flipoyo/MOLONARI-hardware/Boite/deploiement/tige/Lien_onshape.md

Cliquez sur ce lien pour avoir accès au Onshape si vous souhaitez modifier: 
https://cad.onshape.com/documents/2f37f9a7a72e3b844bc26cf5/w/325063e0cb311e8a45c4c956/e/2f46907a06a0c7d93dc3eaa5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
Sinon vous avez directement le document STL.
