flipoyo/MOLONARI-hardware/specs/v2-2025/sensors/temperature sensor/RECORDS_corrige.xlsx

Sheet: Measurements
Device_ID | Record | Date | Time | Value_1 | Value_2 | Value_3 | Value_4 | Value_5 | Last_number | True_temperature_C | Last number normalized
a8610a34334d710d | 7 | 30/10/2026 | 14:40:03 | 1773 | 2502 | 2036 | 2002 | 2031 | 2013 | 20 | 1.622197802
a8610a34334d710d | 8 | 30/10/2026 | 14:40:08 | 1763 | 2503 | 2035 | 2000 | 2026 | 2010 | 20 | 1.61978022
a8610a34334d710d | 9 | 30/10/2026 | 14:40:13 | 1802 | 2502 | 2038 | 2003 | 2030 | 2014 | 20 | 1.623003663
a8610a34334d710d | 10 | 30/10/2026 | 14:40:18 | 1765 | 2504 | 2038 | 2002 | 2029 | 2011 | 20 | 1.620586081
a8610a34334d710d | 11 | 30/10/2026 | 14:40:23 | 1791 | 2504 | 2040 | 2005 | 2031 | 2011 | 20 | 1.620586081
a8610a34334d710d | 12 | 30/10/2026 | 14:40:28 | 1810 | 2507 | 2038 | 2004 | 2027 | 2010 | 20 | 1.61978022
a8610a34334d710d | 13 | 30/10/2026 | 14:40:33 | 1793 | 2508 | 2039 | 2004 | 2030 | 2015 | 20 | 1.623809524
a8610a34334d710d | 14 | 30/10/2026 | 14:40:38 | 1787 | 2508 | 2038 | 2003 | 2028 | 2012 | 20 | 1.621391941
a8610a34334d710d | 15 | 30/10/2026 | 14:40:43 | 1795 | 2507 | 2041 | 2002 | 2028 | 2014 | 20 | 1.623003663
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
