flipoyo/MOLONARI-hardware/docs/Images/atmocommand_sine.png

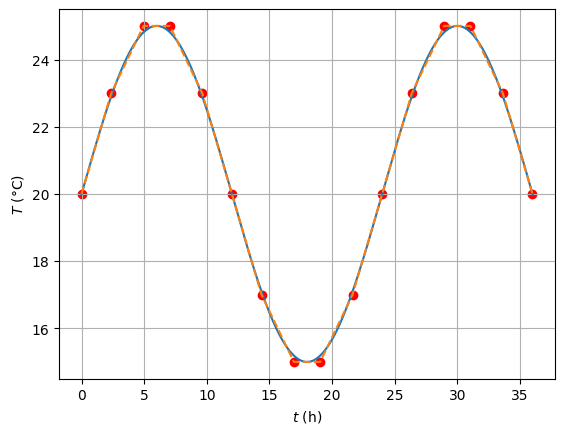
docs/Images/atmocommand_sine.png
