flipoyo/MOLONARI-hardware/docs/Images/basic_station.png

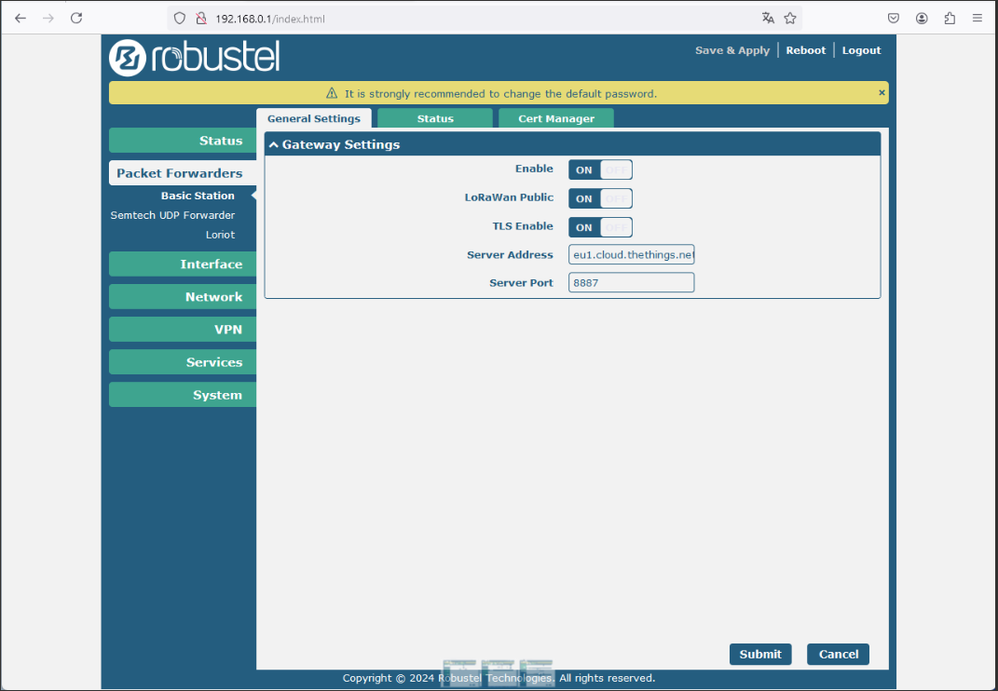
docs/Images/basic_station.png
