flipoyo/MOLONARI-hardware/docs/Images/begin.jpg

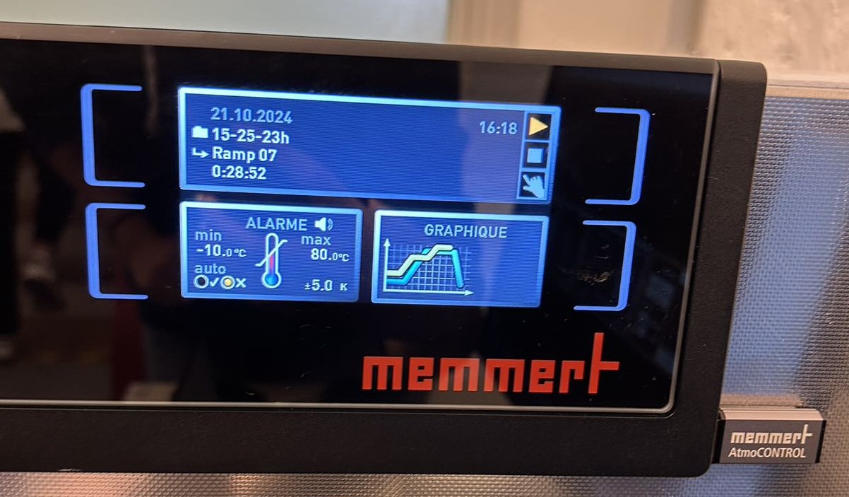
docs/Images/begin.jpg
