flipoyo/MOLONARI-hardware/docs/Images/button.png

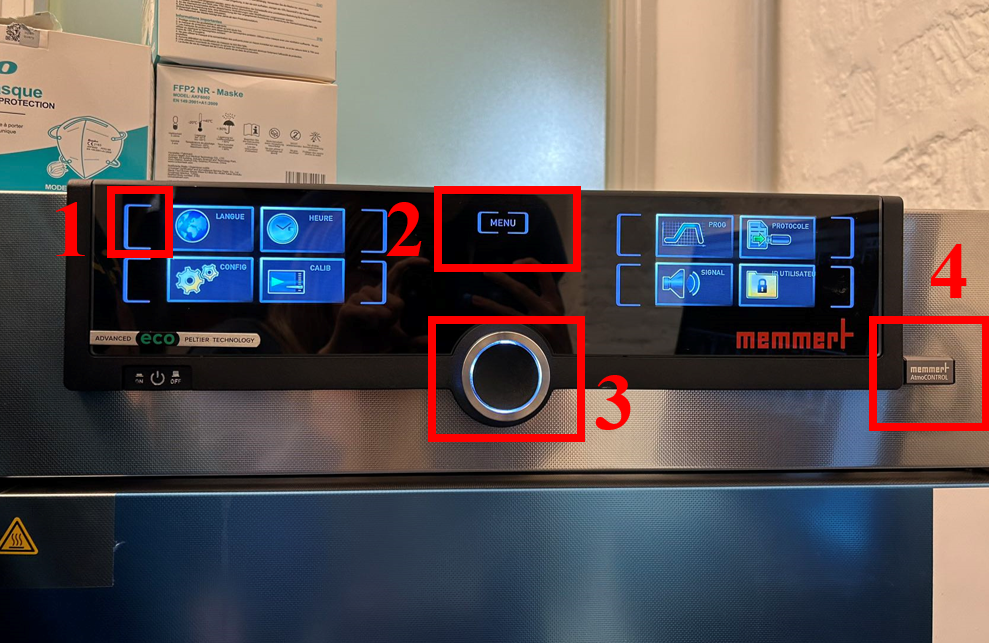
docs/Images/button.png
