flipoyo/MOLONARI-hardware/docs/Images/Cert_manager.png

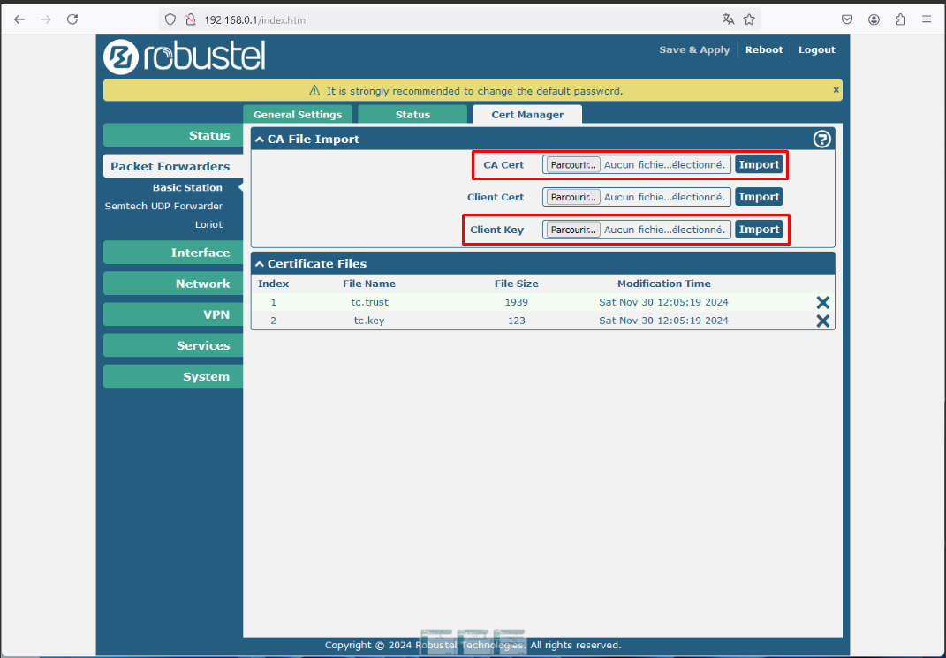
docs/Images/Cert_manager.png
