flipoyo/MOLONARI-hardware/docs/Images/Chaine_informations.jpg

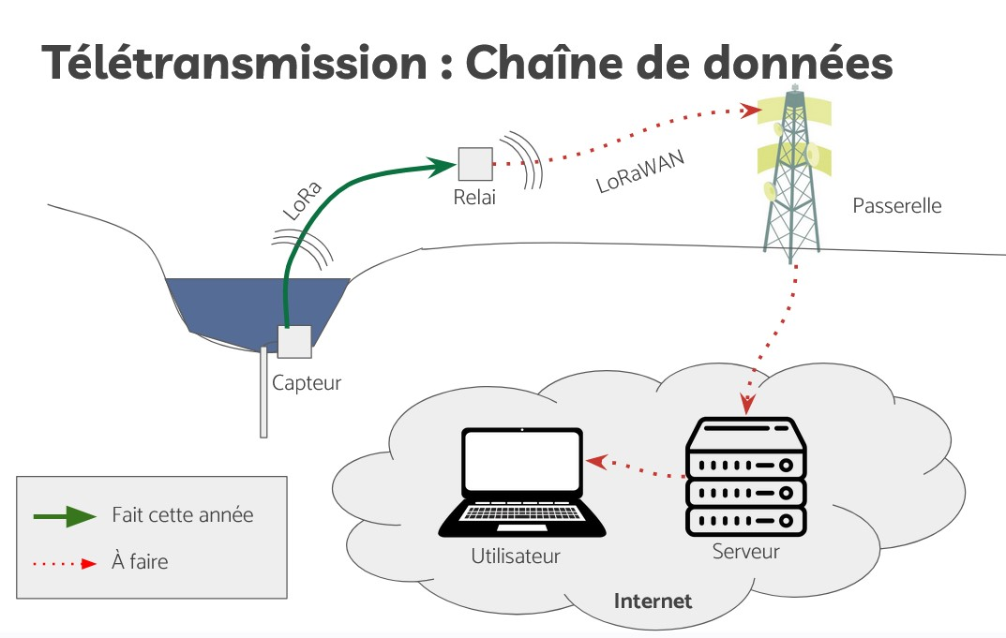
docs/Images/Chaine_informations.jpg
