flipoyo/MOLONARI-hardware/docs/Images/create_programs.png

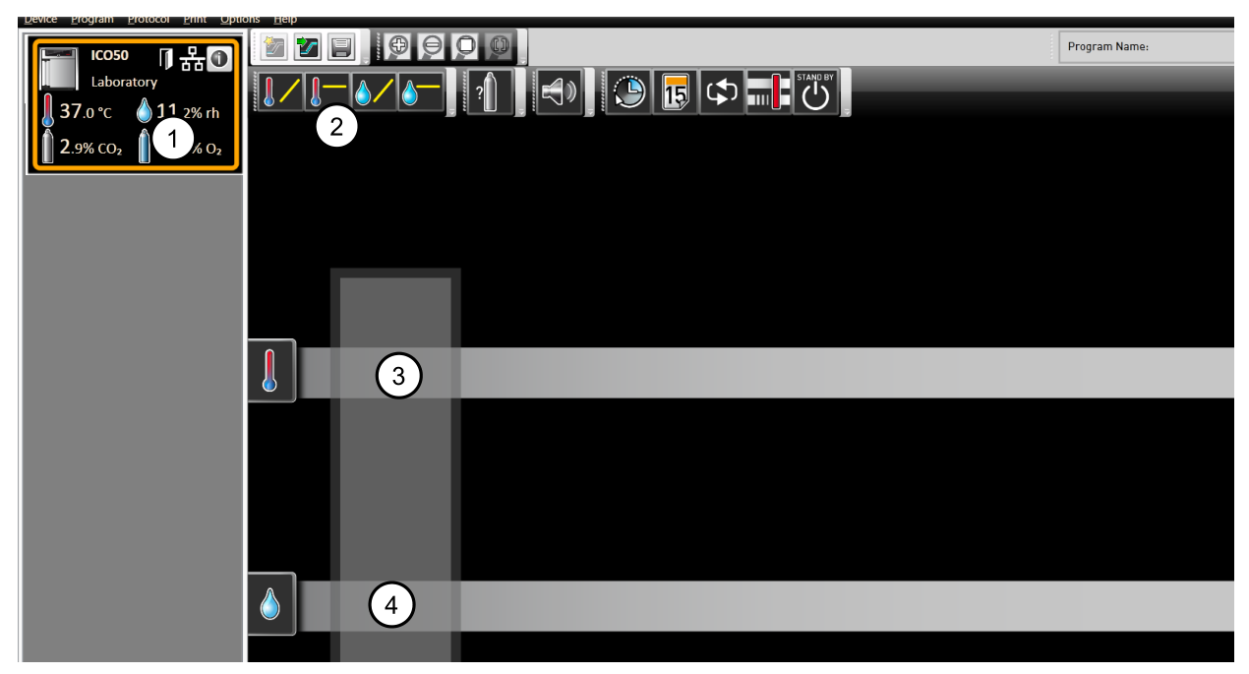
docs/Images/create_programs.png
