flipoyo/MOLONARI-hardware/docs/Images/download.png

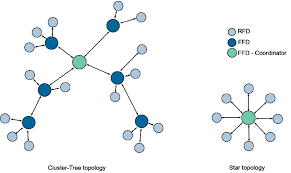
docs/Images/download.png
