flipoyo/MOLONARI-hardware/docs/Images/drag.png

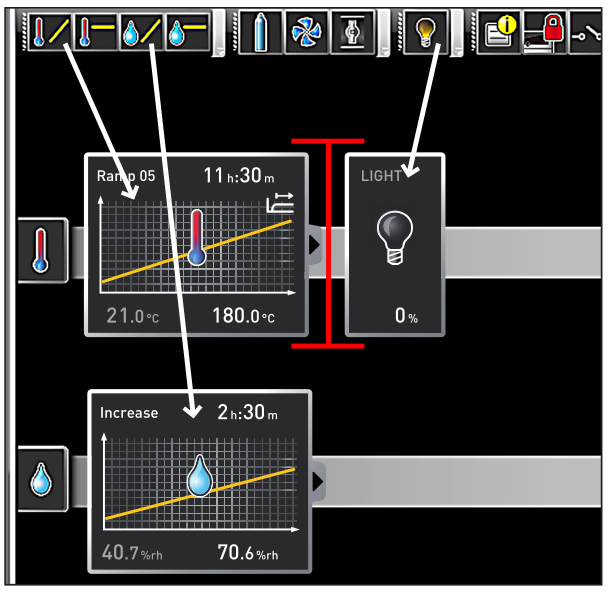
docs/Images/drag.png
