flipoyo/MOLONARI-hardware/docs/Images/first.png

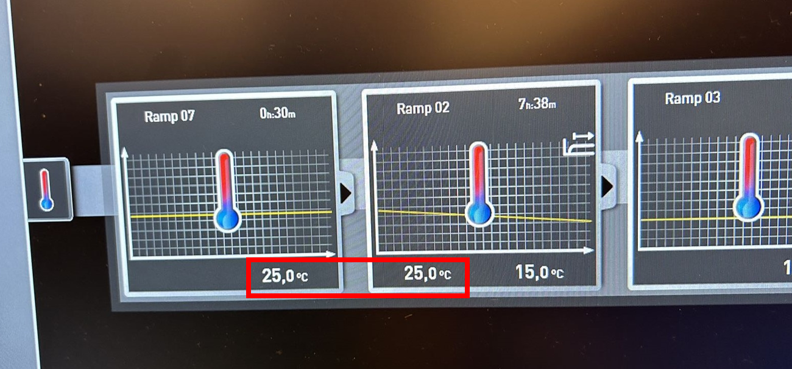
docs/Images/first.png
