flipoyo/MOLONARI-hardware/docs/Images/interface.png

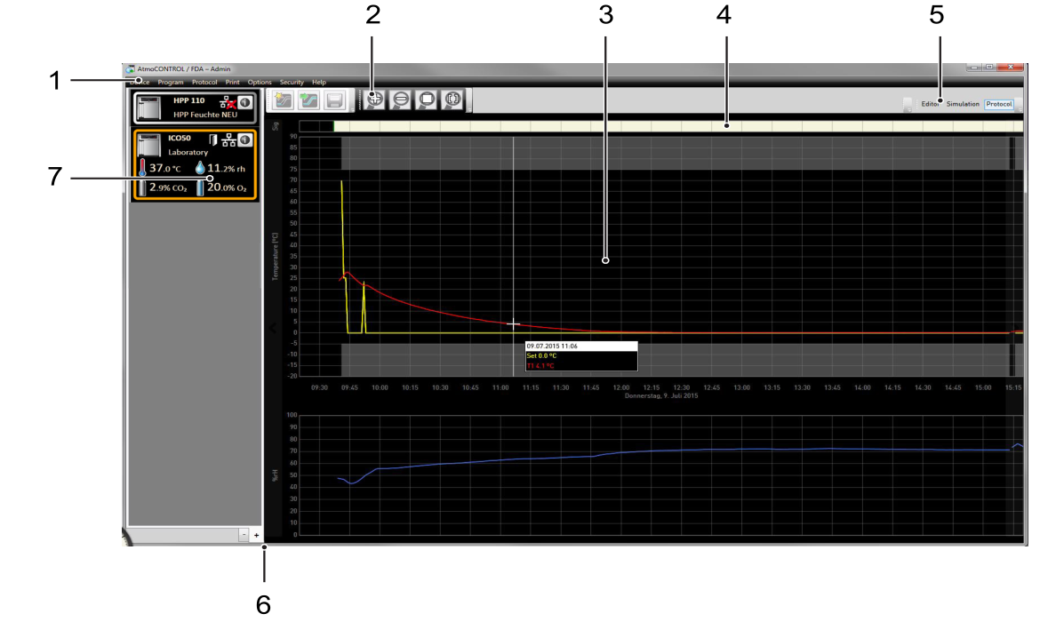
docs/Images/interface.png
