flipoyo/MOLONARI-hardware/docs/Images/json_data.png

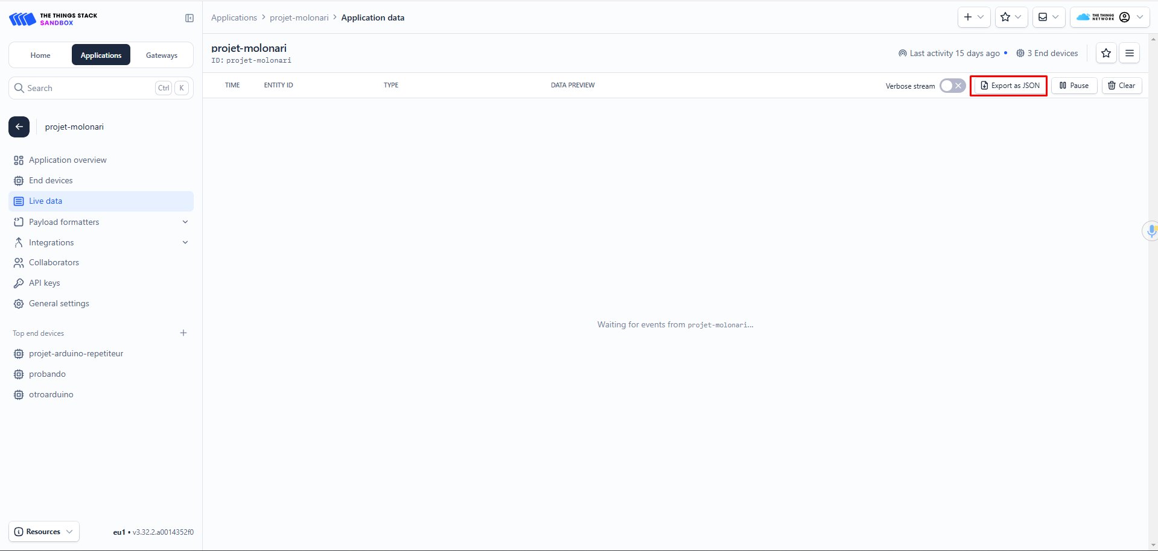
docs/Images/json_data.png
