flipoyo/MOLONARI-hardware/docs/Images/menu_bar.png

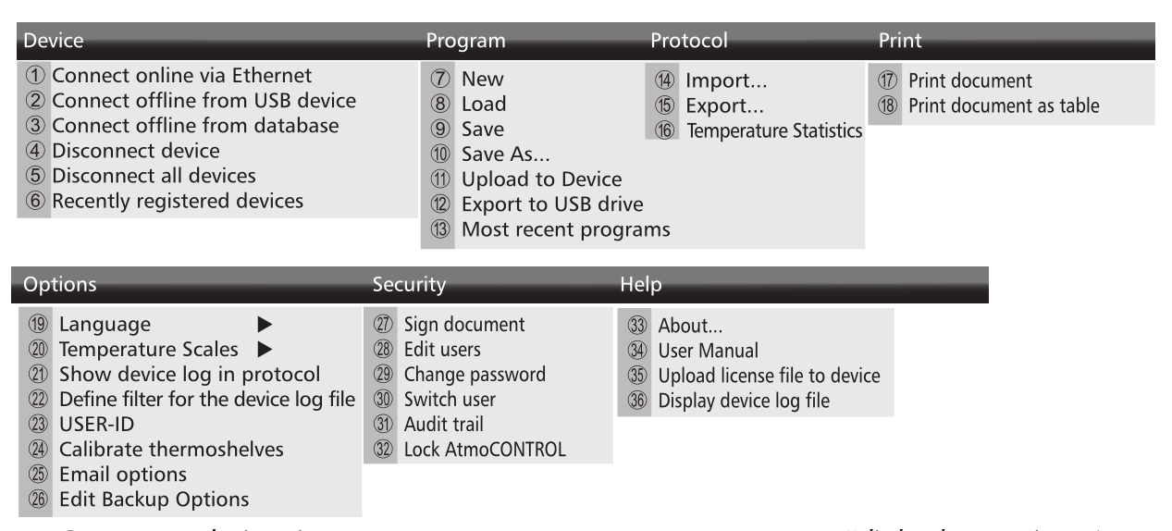
docs/Images/menu_bar.png
