flipoyo/MOLONARI-hardware/docs/Images/off_semtech.png

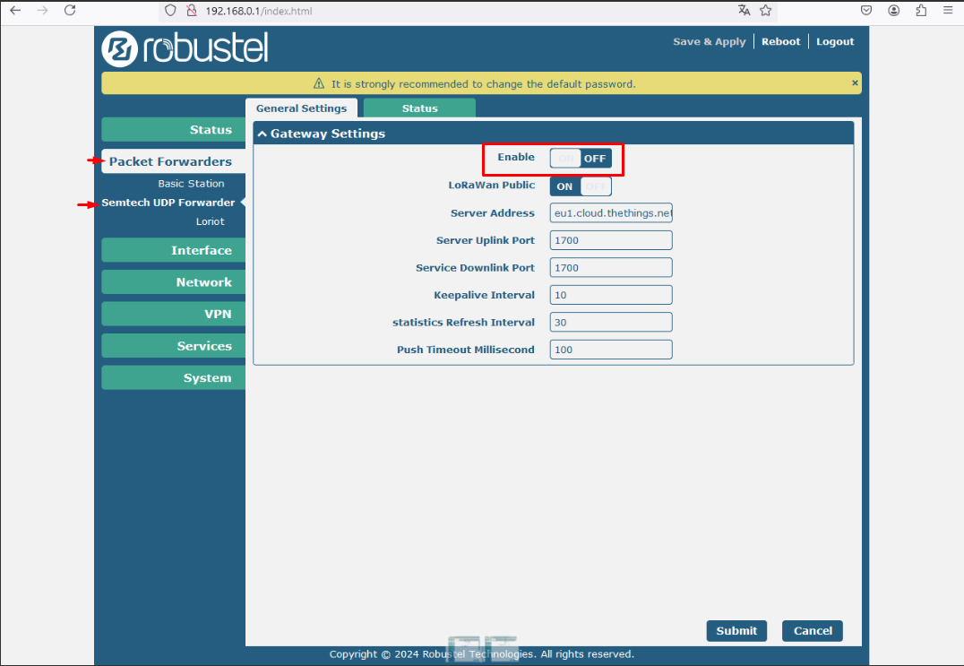
docs/Images/off_semtech.png
