flipoyo/MOLONARI-hardware/docs/Images/para.png

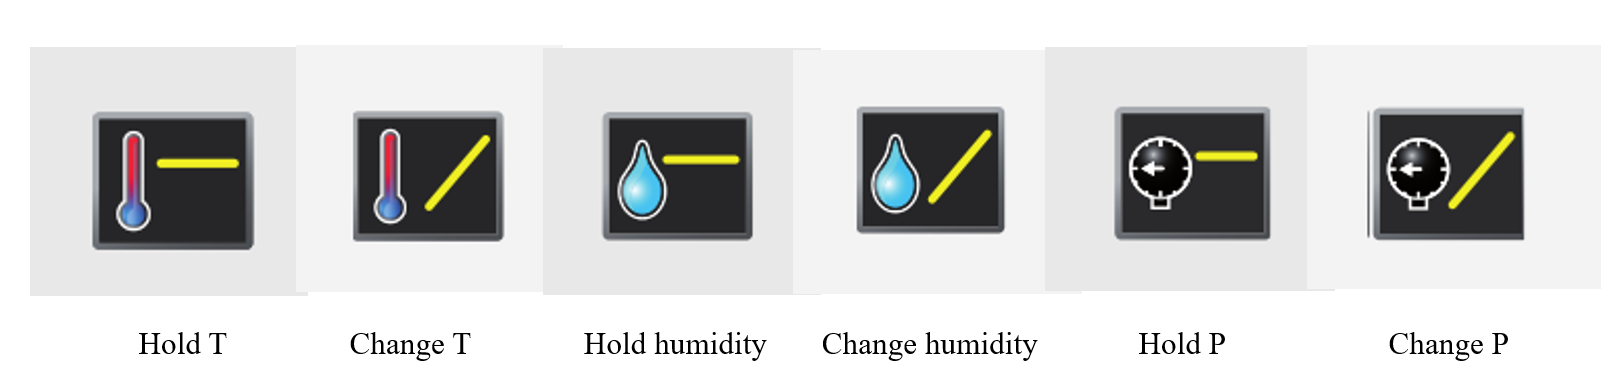
docs/Images/para.png
