flipoyo/MOLONARI-hardware/docs/Images/parameters.png

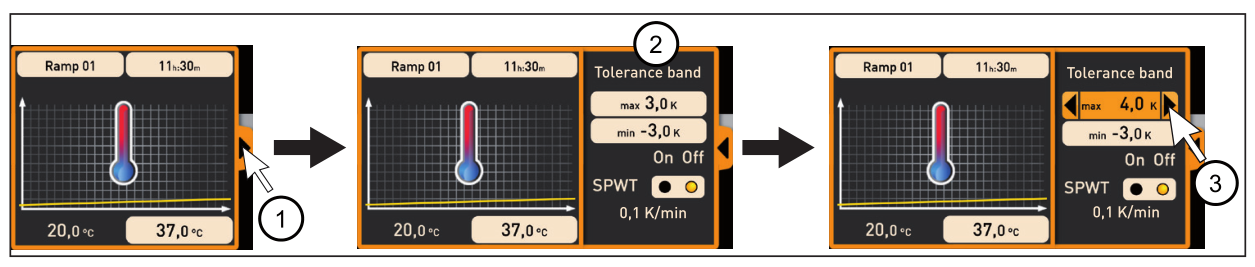
docs/Images/parameters.png
