flipoyo/MOLONARI-hardware/docs/Images/root_pem.png

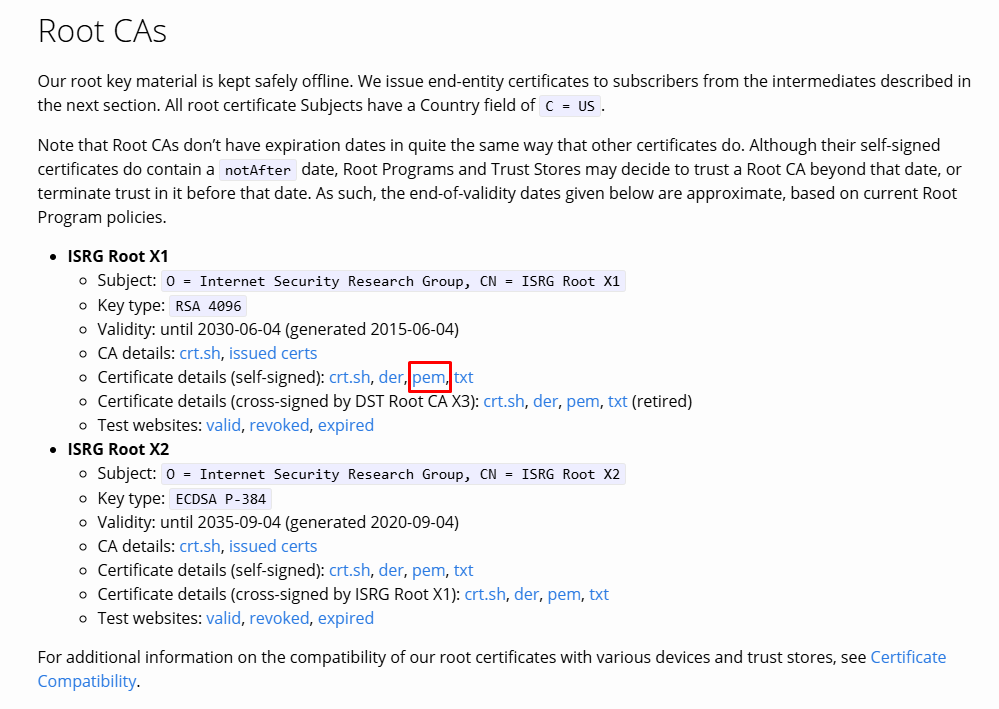
docs/Images/root_pem.png
