flipoyo/MOLONARI-hardware/docs/Images/run.jpg

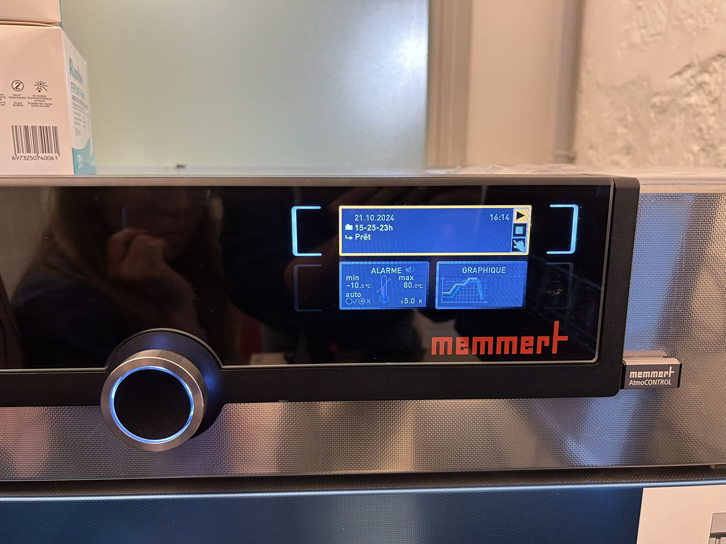
docs/Images/run.jpg
