flipoyo/MOLONARI-hardware/docs/Images/save.jpg

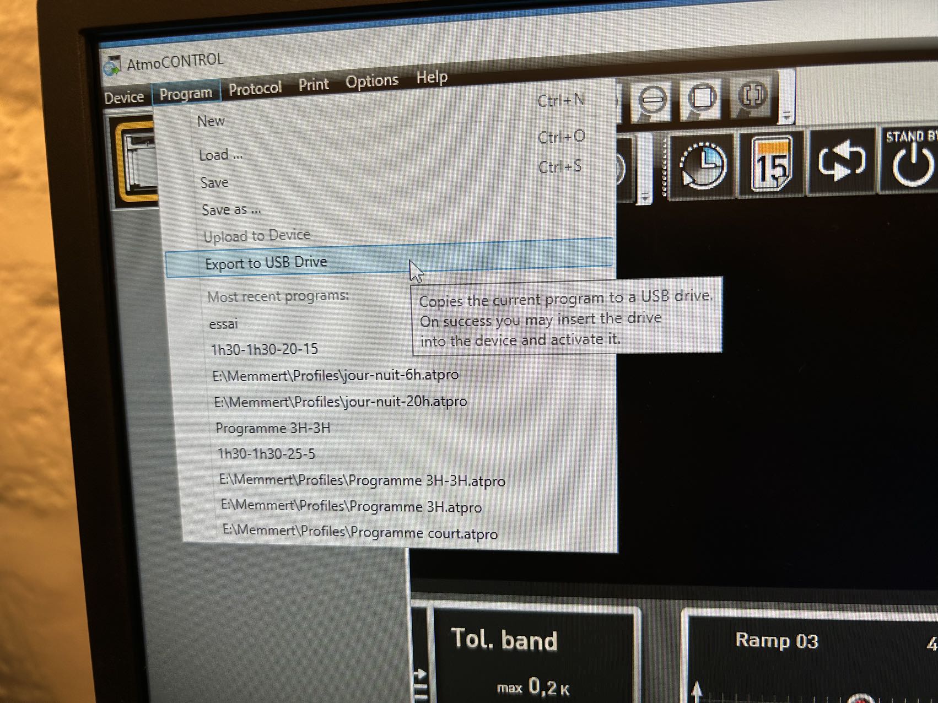
docs/Images/save.jpg
