flipoyo/MOLONARI-hardware/docs/Images/schéma_branchement.png

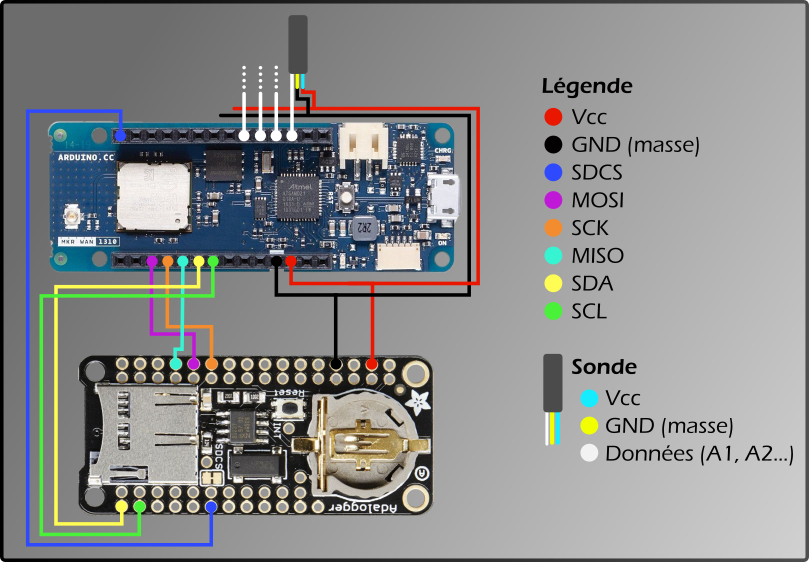
docs/Images/schéma_branchement.png
