flipoyo/MOLONARI-hardware/docs/Images/Screenshot2024-11-30.png

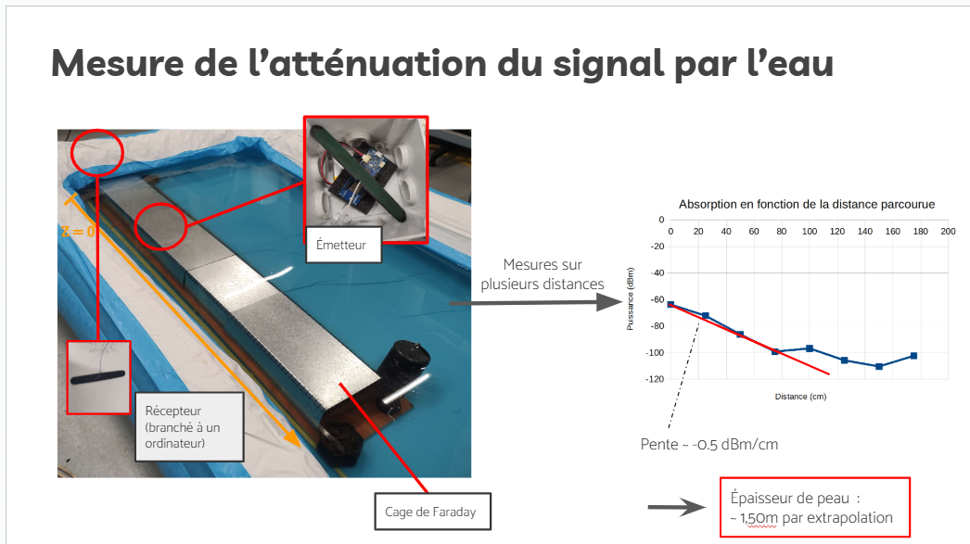
docs/Images/Screenshot2024-11-30.png
