flipoyo/MOLONARI-hardware/docs/Images/select.jpg

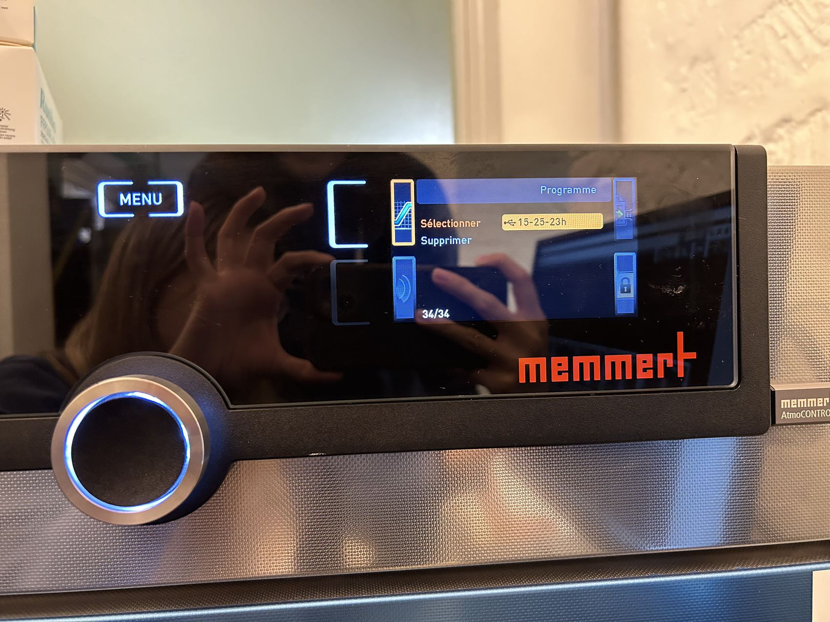
docs/Images/select.jpg
