flipoyo/MOLONARI-hardware/docs/Images/sinus_to_trapezoid.jpg

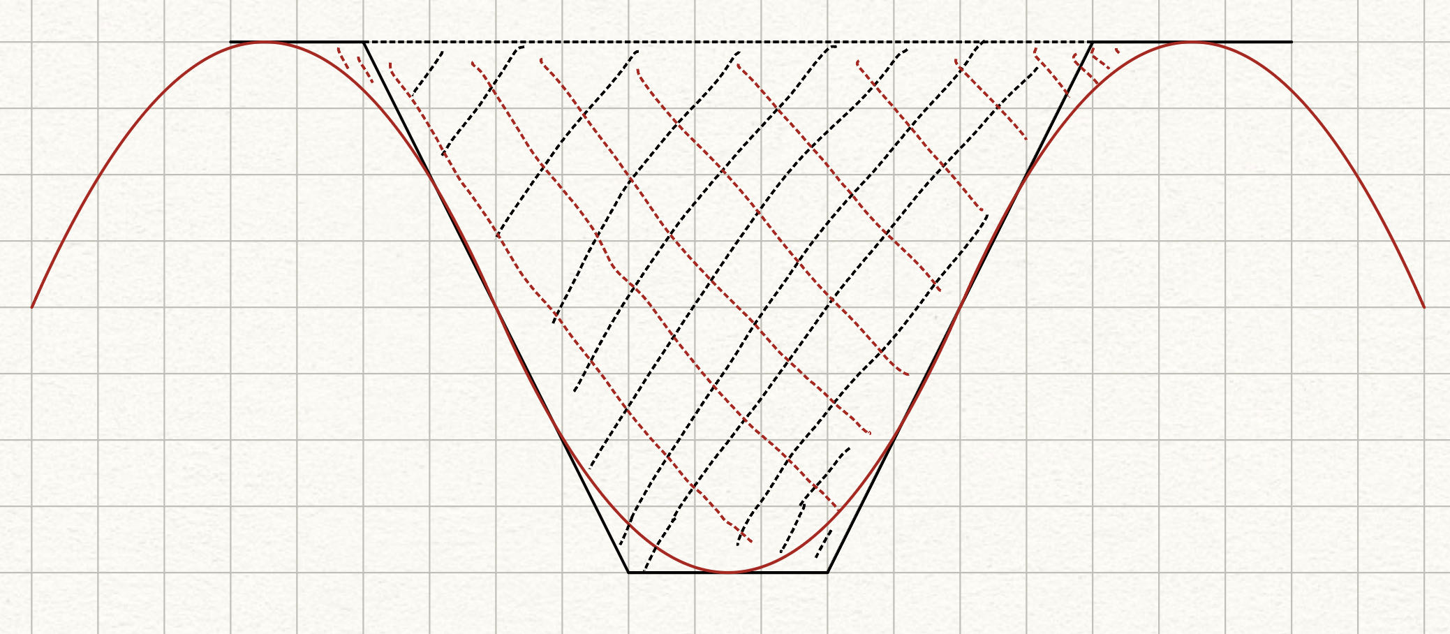
docs/Images/sinus_to_trapezoid.jpg
