flipoyo/MOLONARI-hardware/docs/Images/SPWT.png

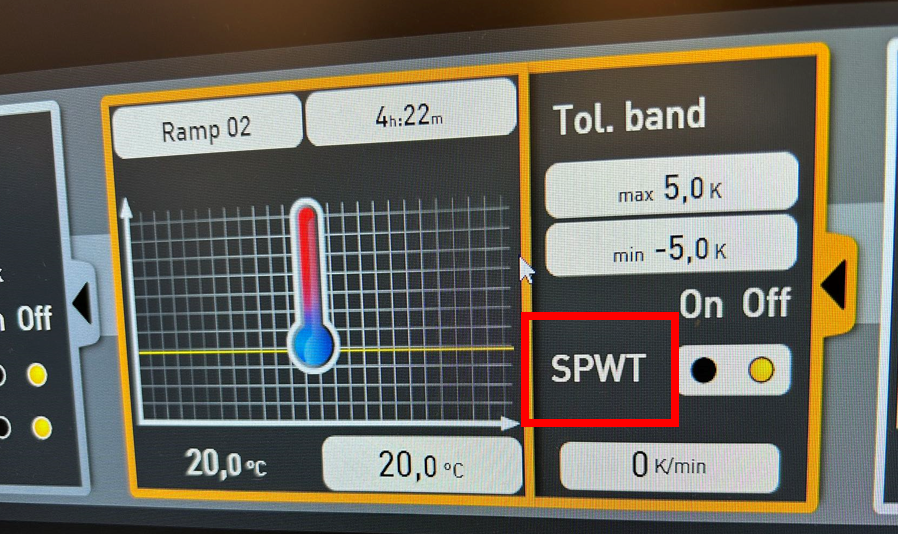
docs/Images/SPWT.png
