flipoyo/MOLONARI-hardware/docs/Images/status_bar.png

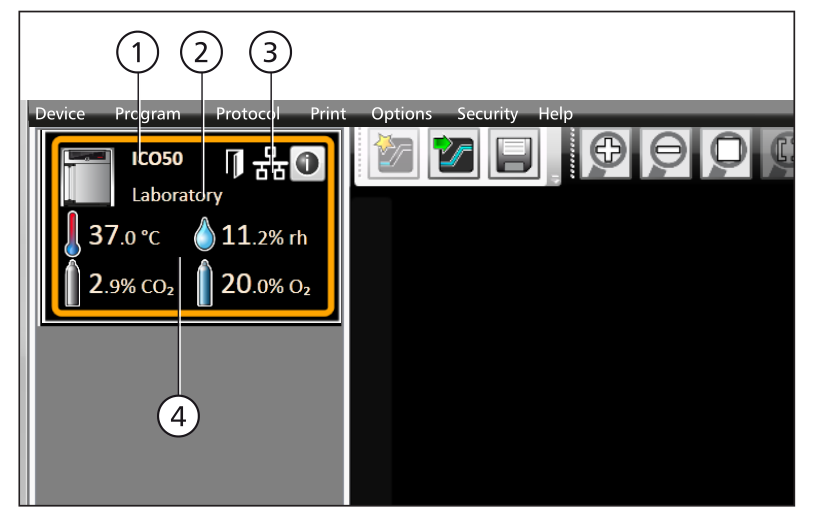
docs/Images/status_bar.png
