flipoyo/MOLONARI-hardware/docs/Images/tol.png

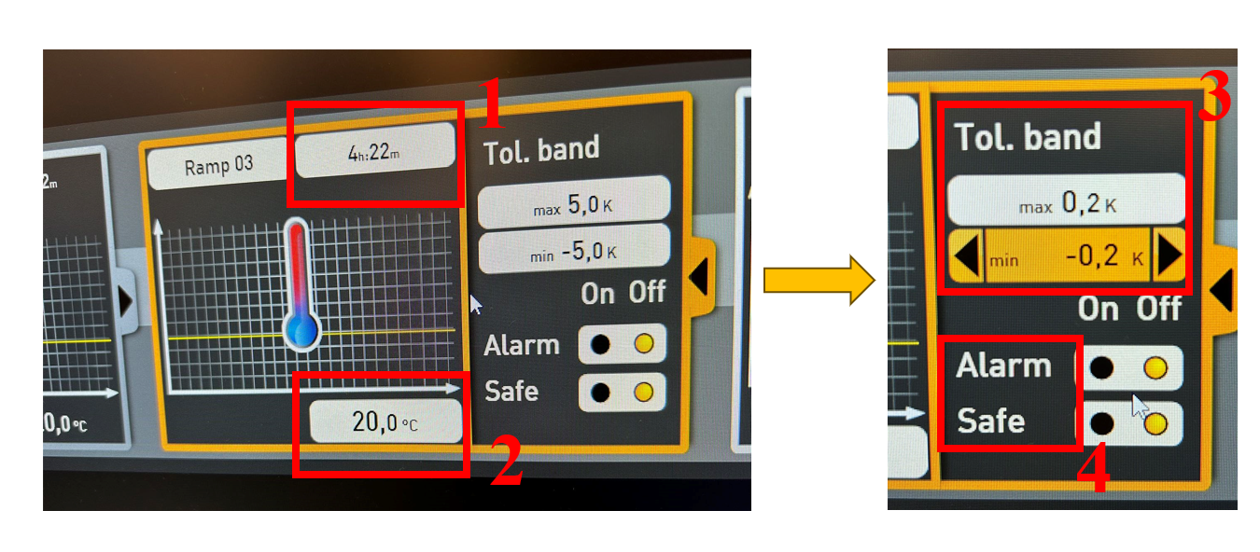
docs/Images/tol.png
