flipoyo/MOLONARI-hardware/docs/Images/toolbar.png

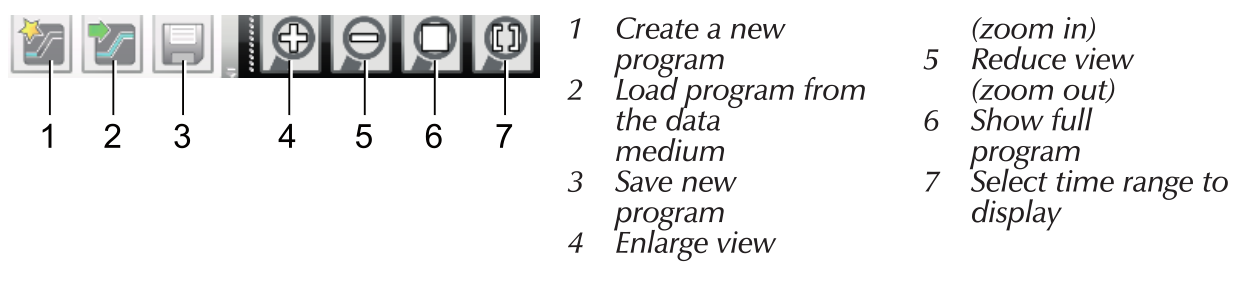
docs/Images/toolbar.png
