flipoyo/MOLONARI-hardware/docs/Images/tree_topology.png

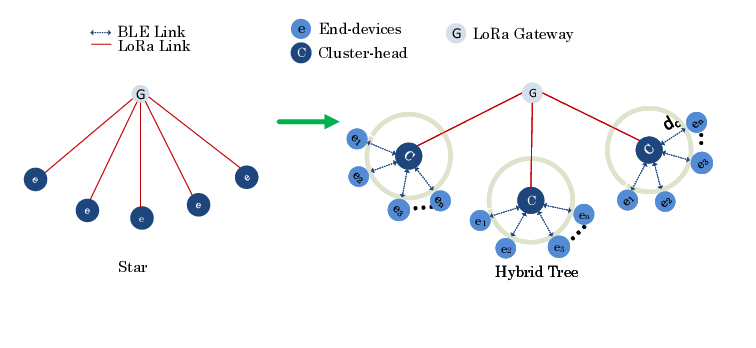
docs/Images/tree_topology.png
