flipoyo/MOLONARI-hardware/docs/Images/v003.jpg

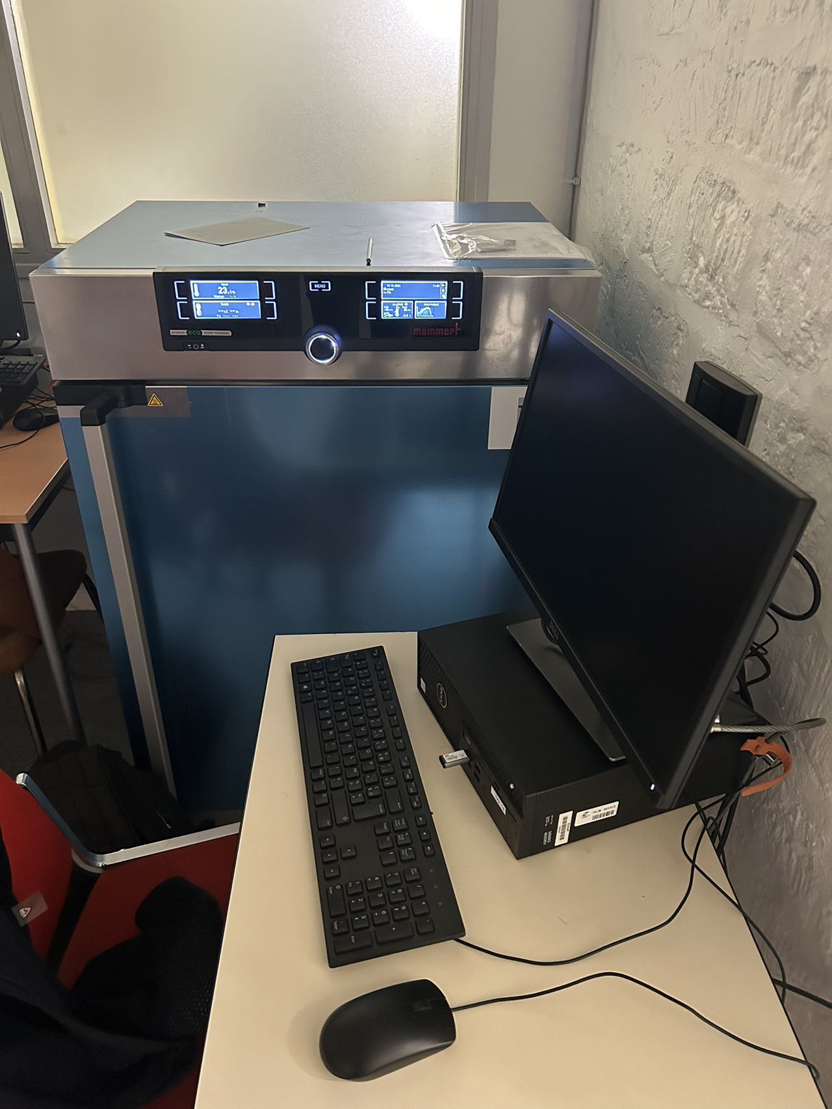
docs/Images/v003.jpg
