flipoyo/MOLONARI-hardware/specs/v1-until-2024/differentialPressureSensor/dimensionSacrificialTip.JPG

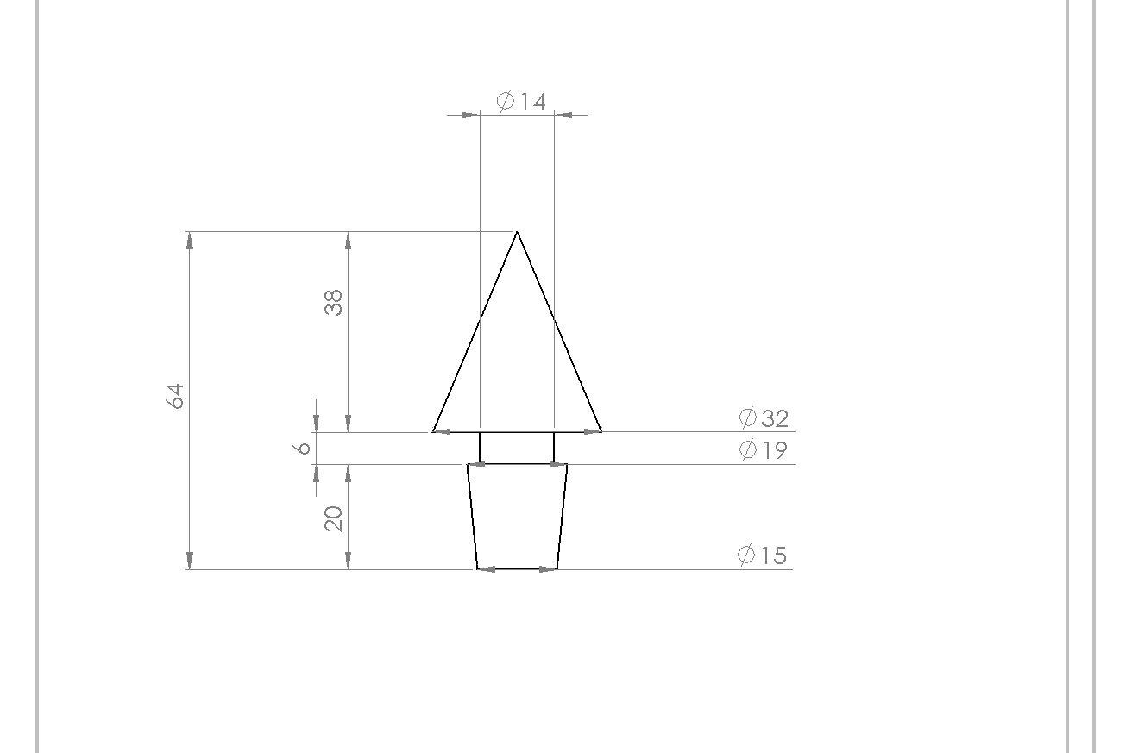
specs/v1-until-2024/differentialPressureSensor/dimensionSacrificialTip.JPG
