flipoyo/MOLONARI-hardware/specs/v1-until-2024/differentialPressureSensor/Schéma_Circuit_crédit_Greswell.jpg

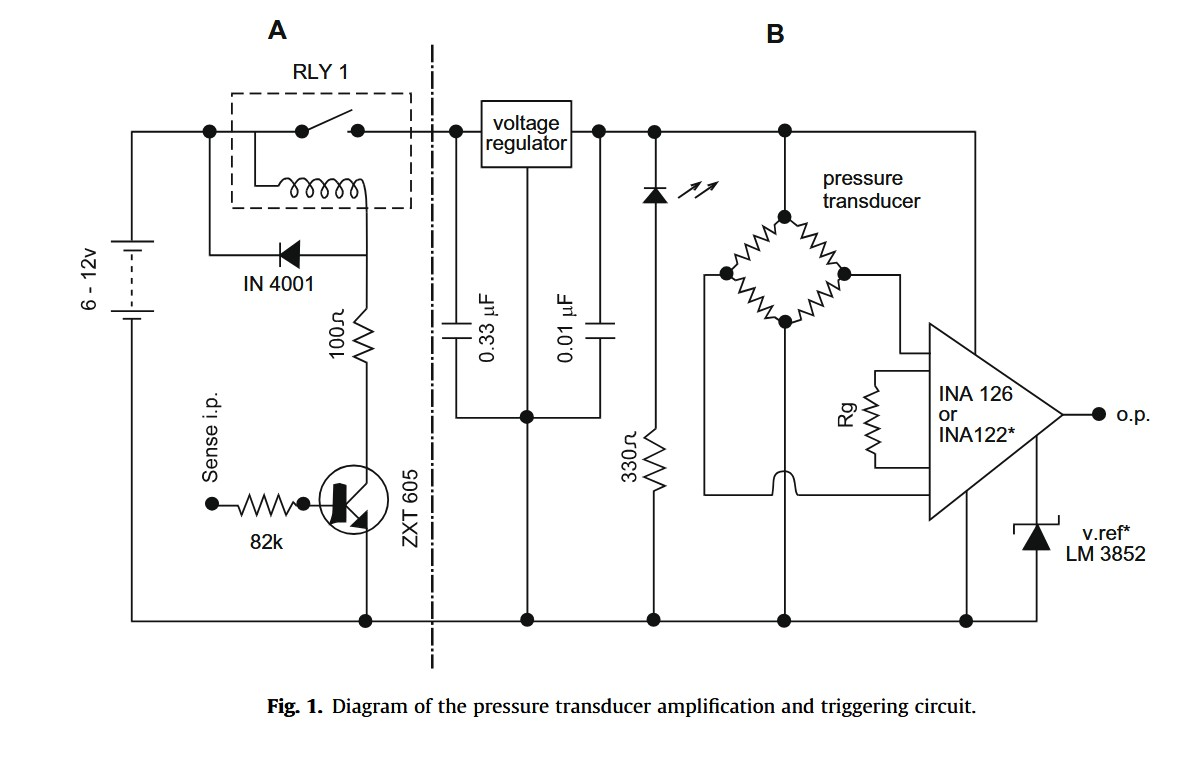
specs/v1-until-2024/differentialPressureSensor/Schéma_Circuit_crédit_Greswell.jpg
