flipoyo/MOLONARI-hardware/specs/v2-2025/electronic connexion/Images/battery_Arduino.jpg

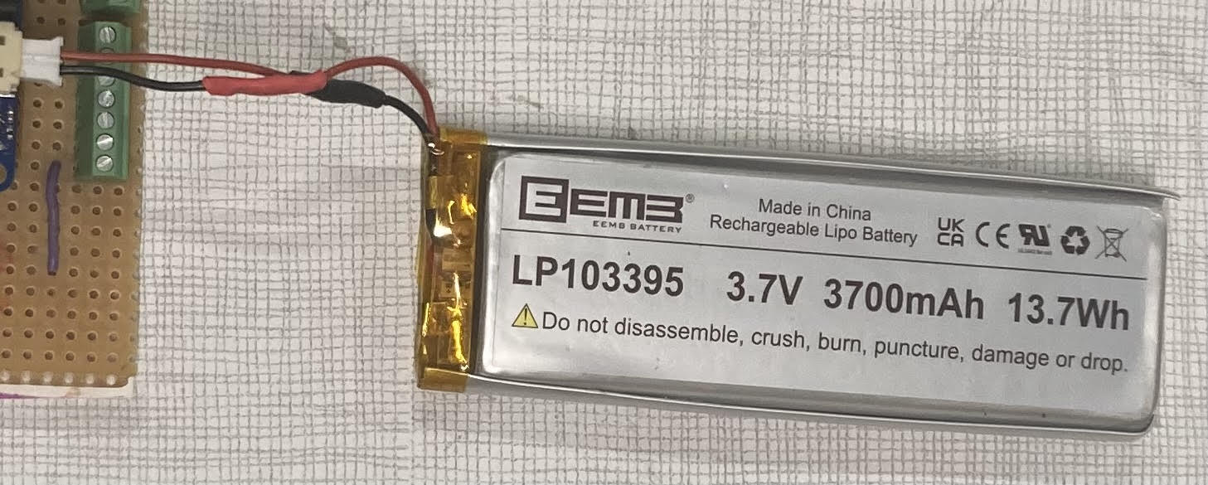
specs/v2-2025/electronic connexion/Images/battery_Arduino.jpg
