flipoyo/MOLONARI-hardware/specs/v2-2025/electronic connexion/Images/circuit_relai_antenne.jpg

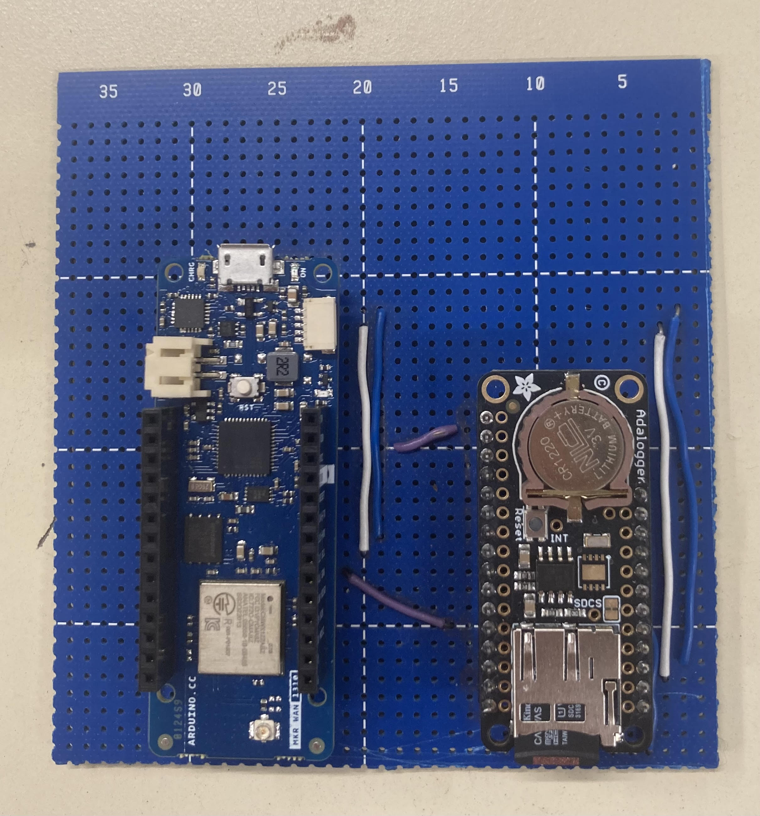
specs/v2-2025/electronic connexion/Images/circuit_relai_antenne.jpg
