flipoyo/MOLONARI-hardware/specs/v2-2025/electronic connexion/Images/circuit_seal.jpg

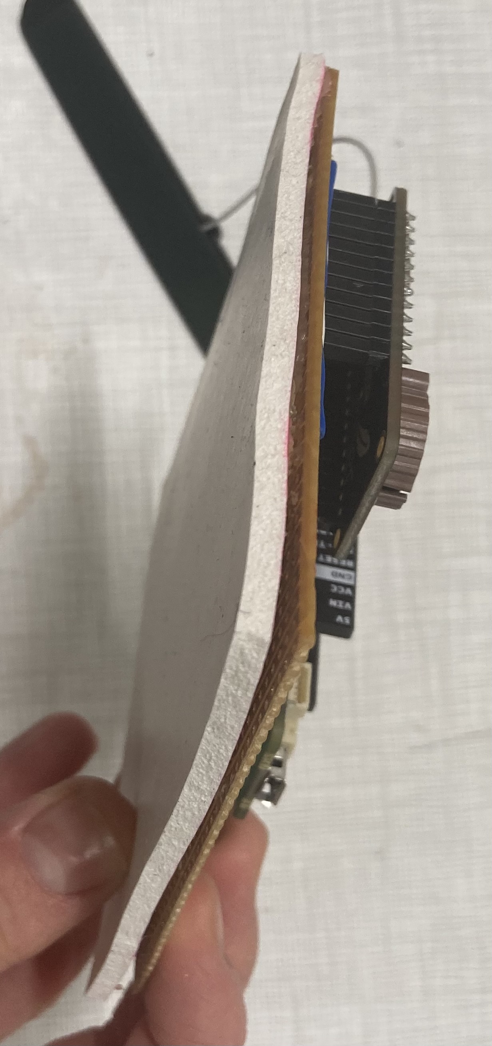
specs/v2-2025/electronic connexion/Images/circuit_seal.jpg
