flipoyo/MOLONARI-hardware/specs/v2-2025/gateway/Images/add_app.png

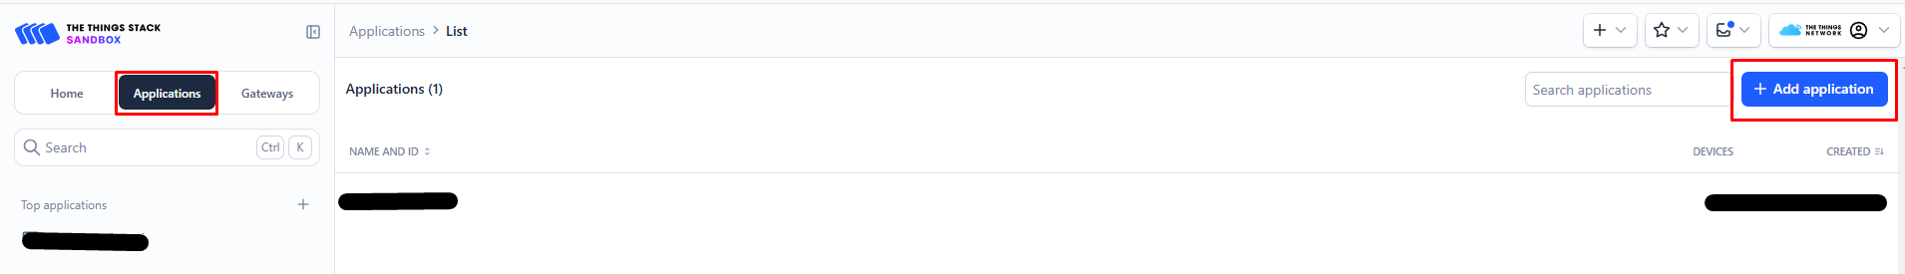
specs/v2-2025/gateway/Images/add_app.png
