flipoyo/MOLONARI-hardware/specs/v2-2025/gateway/Images/App_version.png

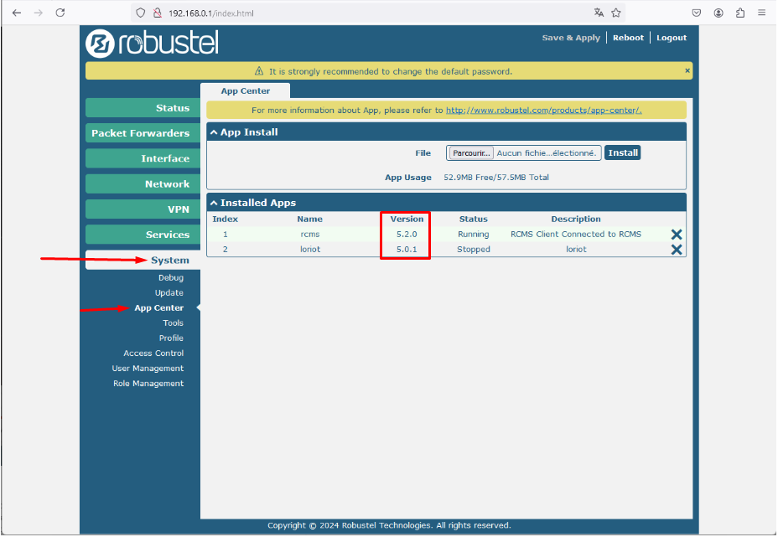
specs/v2-2025/gateway/Images/App_version.png
