flipoyo/MOLONARI-hardware/specs/v2-2025/gateway/Images/basic_station2.png

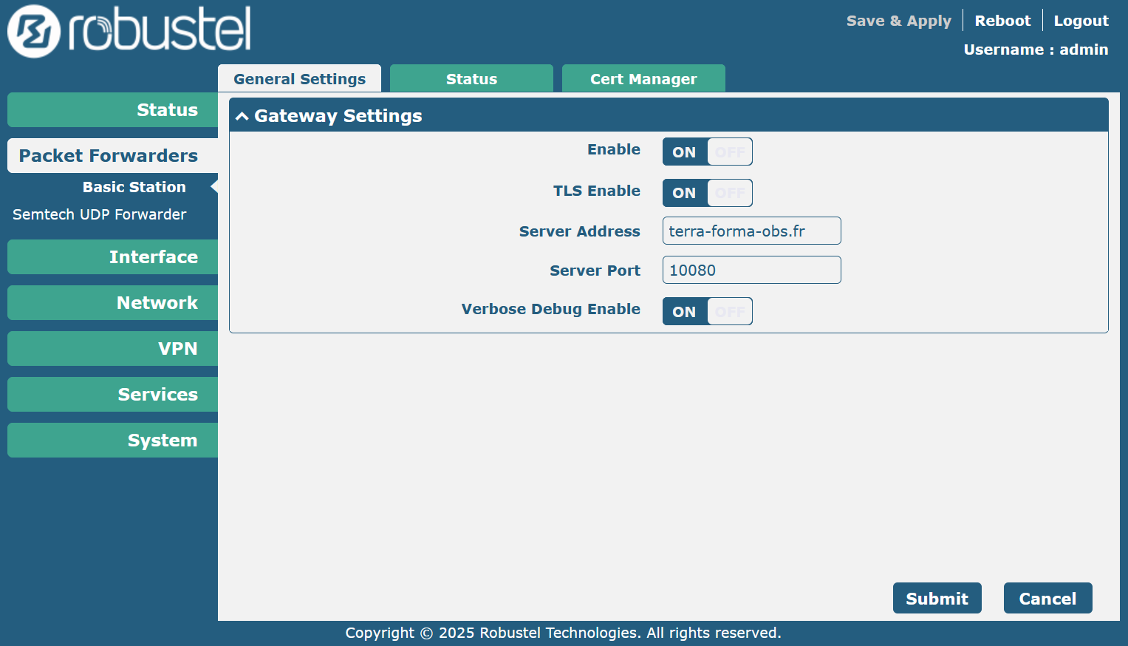
specs/v2-2025/gateway/Images/basic_station2.png
