flipoyo/MOLONARI-hardware/specs/v2-2025/gateway/Images/chirpstack_adding_sensor.png

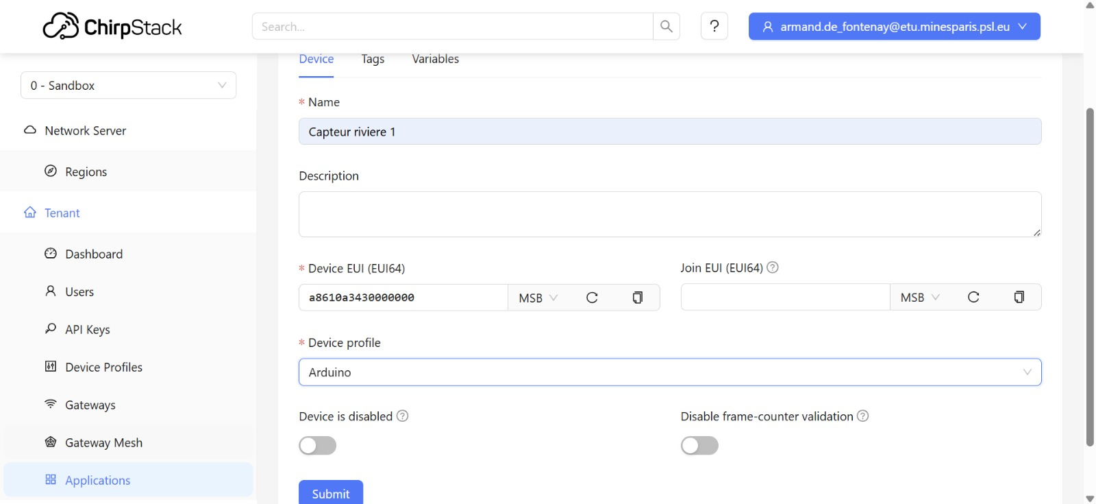
specs/v2-2025/gateway/Images/chirpstack_adding_sensor.png
