flipoyo/MOLONARI-hardware/specs/v2-2025/gateway/Images/chirpstack_gateways.png

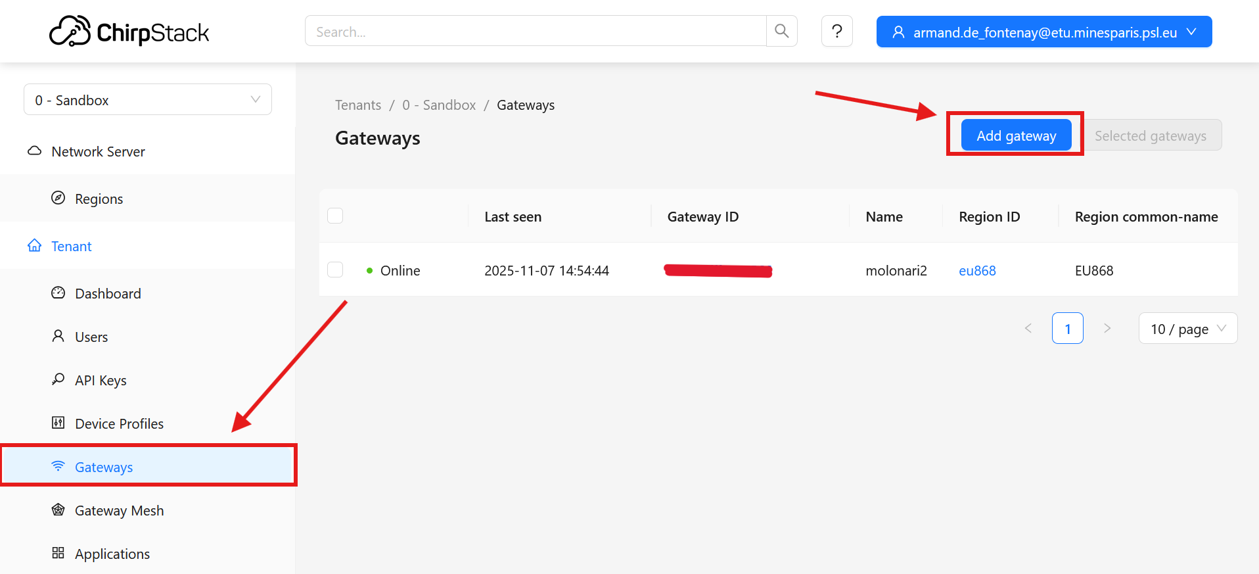
specs/v2-2025/gateway/Images/chirpstack_gateways.png
