flipoyo/MOLONARI-hardware/specs/v2-2025/gateway/Images/chirpstack_generate_certificates1.png

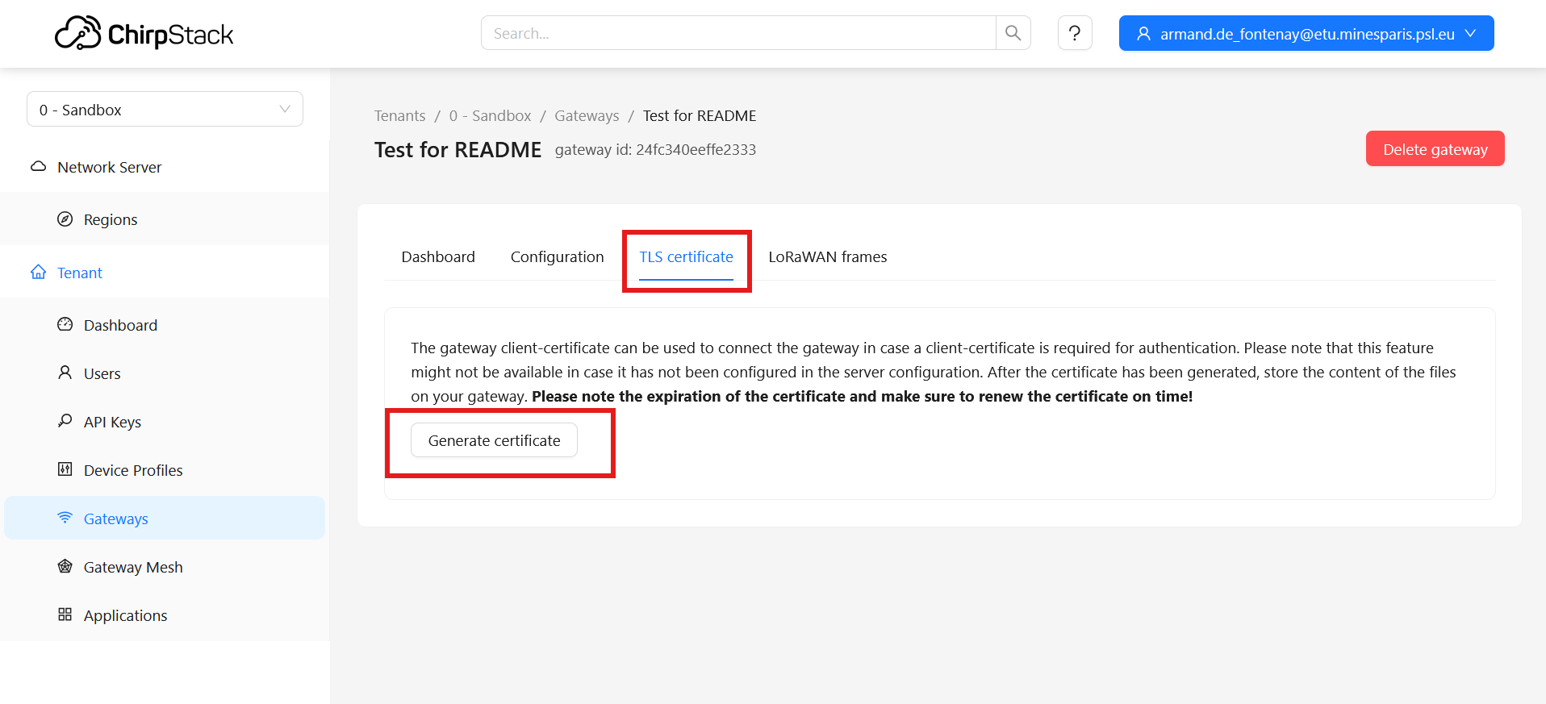
specs/v2-2025/gateway/Images/chirpstack_generate_certificates1.png
