flipoyo/MOLONARI-hardware/specs/v2-2025/gateway/Images/chirpstack_login.png

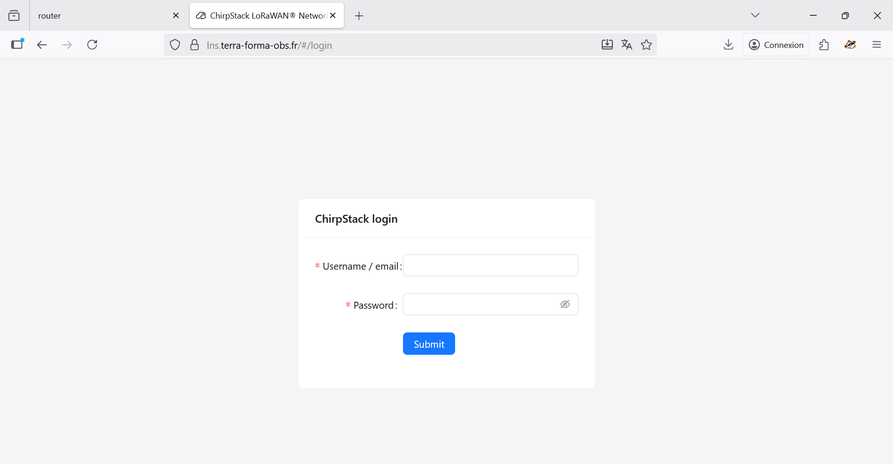
specs/v2-2025/gateway/Images/chirpstack_login.png
