flipoyo/MOLONARI-hardware/specs/v2-2025/gateway/Images/chirpstack_seeing_messages.png

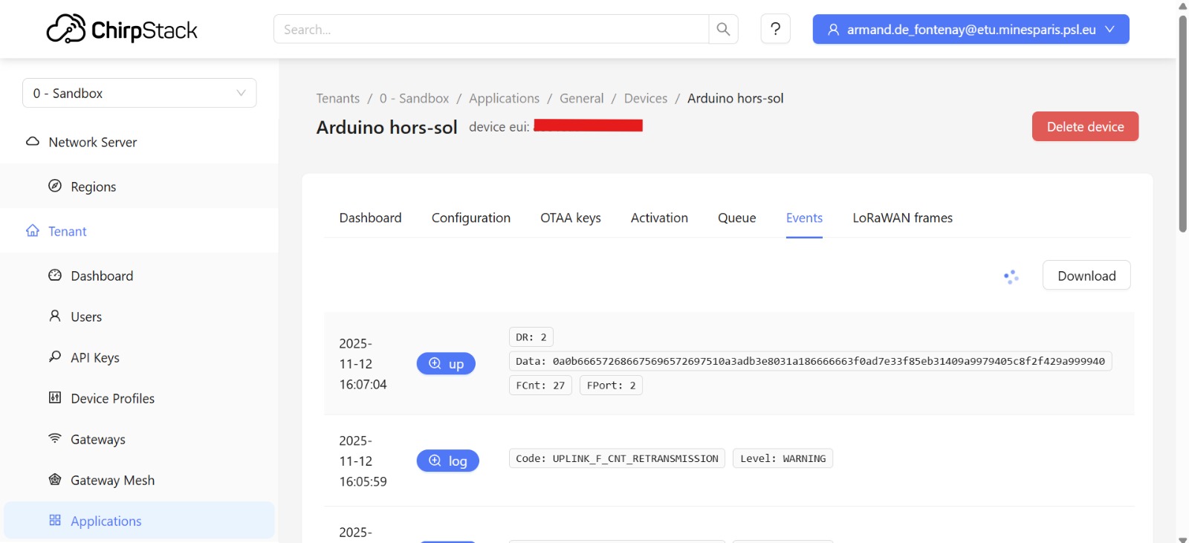
specs/v2-2025/gateway/Images/chirpstack_seeing_messages.png
