flipoyo/MOLONARI-hardware/specs/v2-2025/gateway/Images/chirpstack_sensor_appkey.png

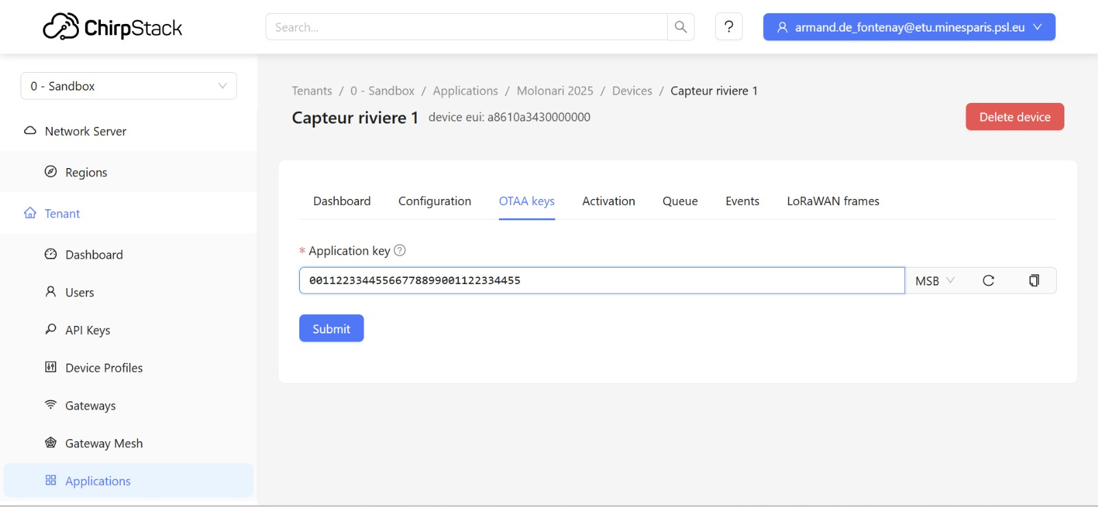
specs/v2-2025/gateway/Images/chirpstack_sensor_appkey.png
