flipoyo/MOLONARI-hardware/specs/v2-2025/gateway/Images/console2.png

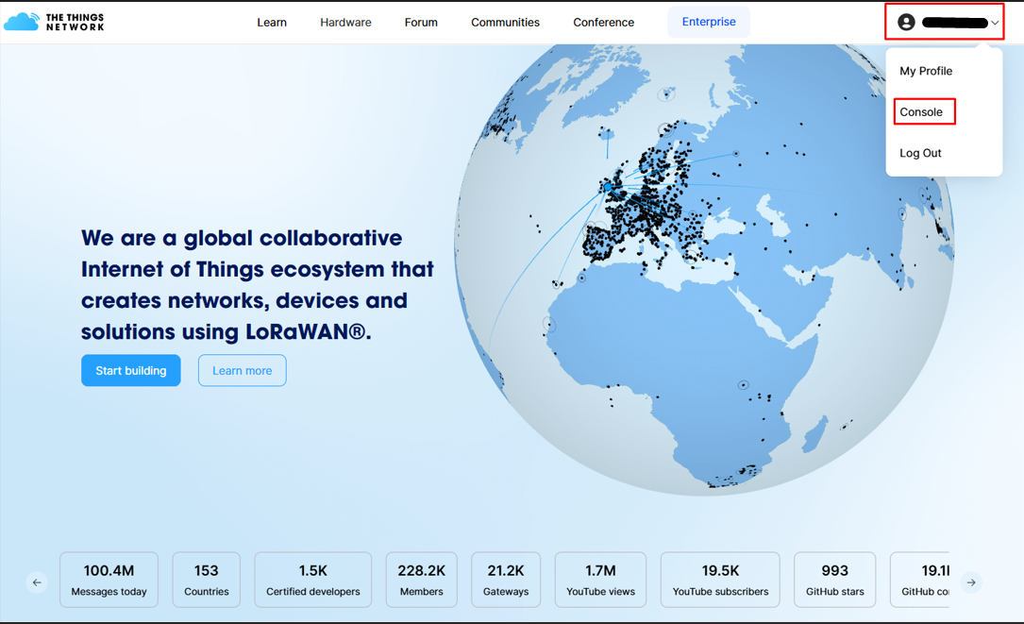
specs/v2-2025/gateway/Images/console2.png
