flipoyo/MOLONARI-hardware/specs/v2-2025/gateway/Images/end_devices.png

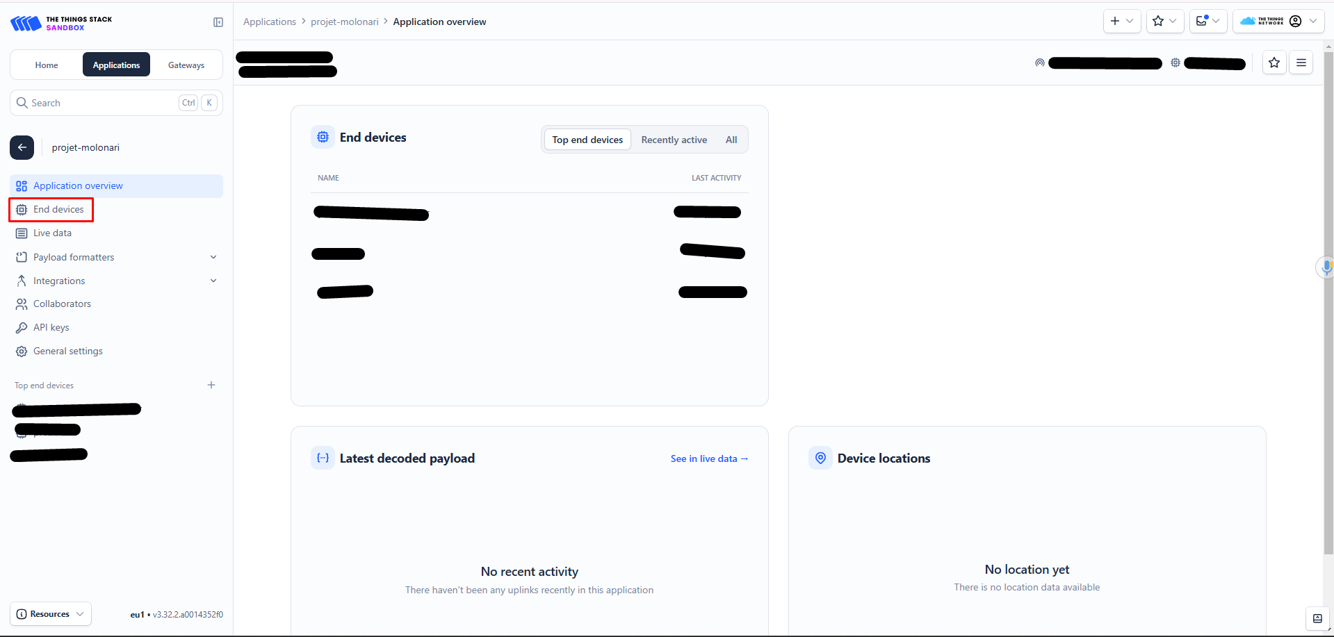
specs/v2-2025/gateway/Images/end_devices.png
