flipoyo/MOLONARI-hardware/specs/v2-2025/gateway/Images/europe1.png

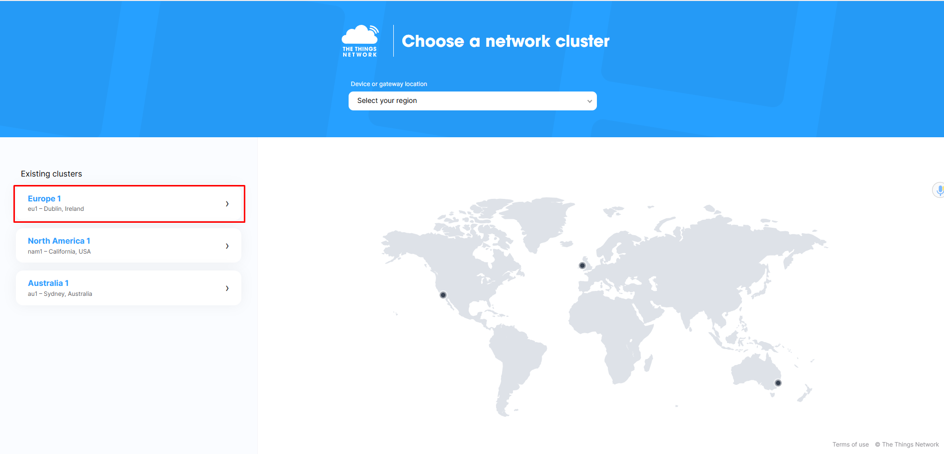
specs/v2-2025/gateway/Images/europe1.png
