flipoyo/MOLONARI-hardware/specs/v2-2025/gateway/Images/gateway_ttn.png

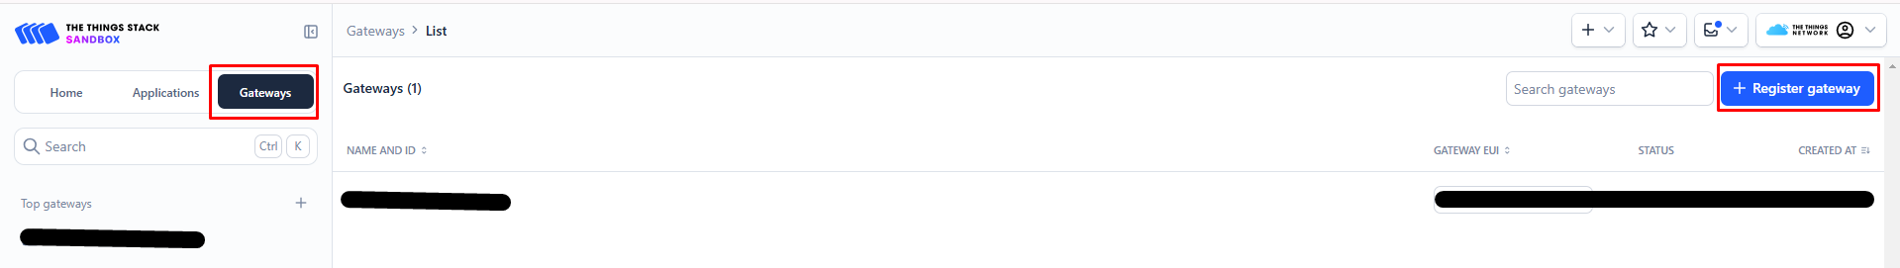
specs/v2-2025/gateway/Images/gateway_ttn.png
