flipoyo/MOLONARI-hardware/specs/v2-2025/gateway/Images/gps_off.png

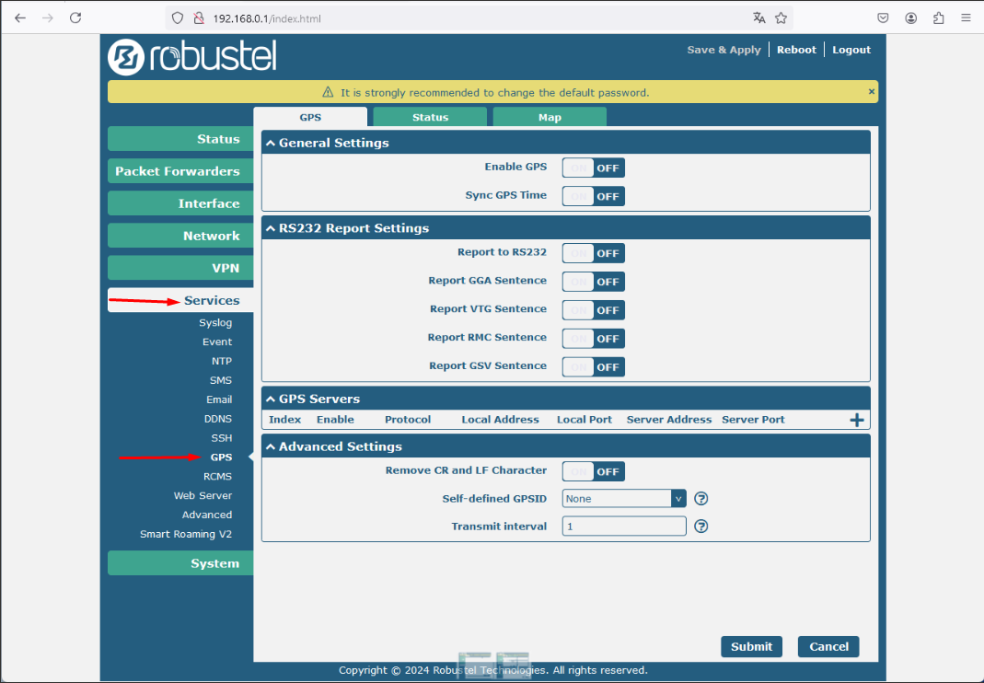
specs/v2-2025/gateway/Images/gps_off.png
