flipoyo/MOLONARI-hardware/specs/v2-2025/gateway/Images/mainpage_TTN2.png

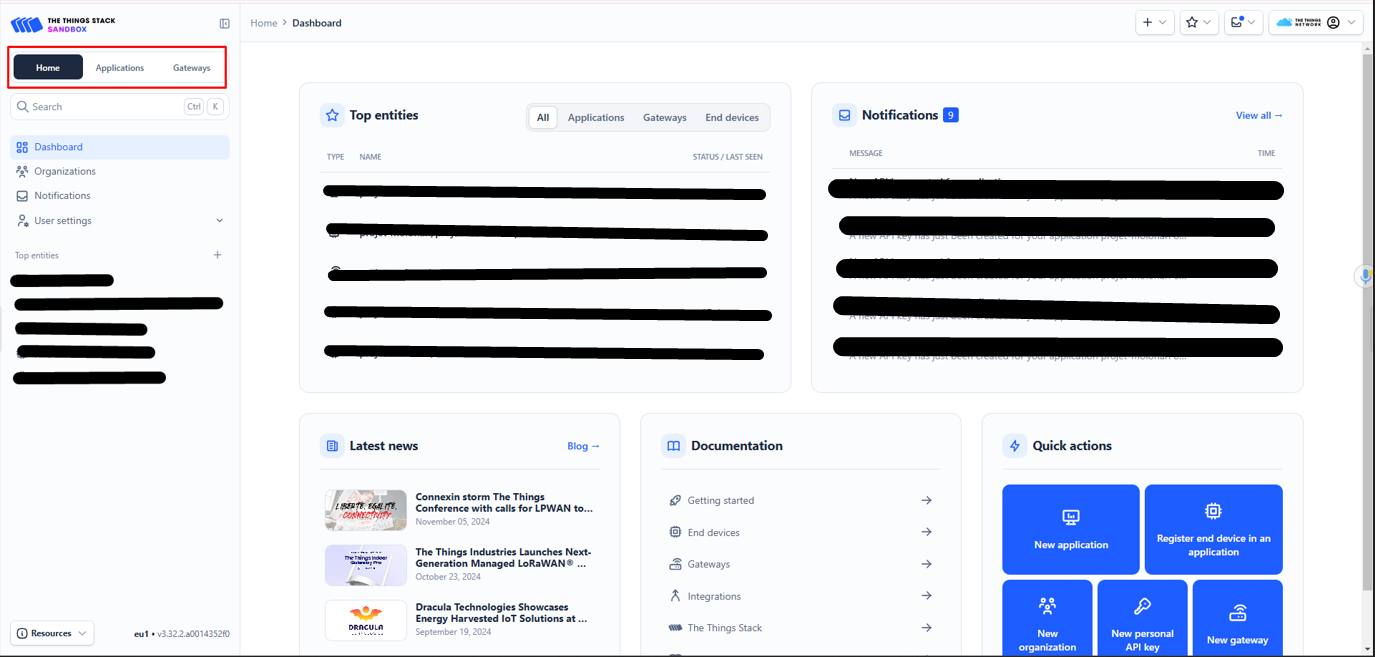
specs/v2-2025/gateway/Images/mainpage_TTN2.png
