flipoyo/MOLONARI-hardware/specs/v2-2025/gateway/Images/ntp_config.png

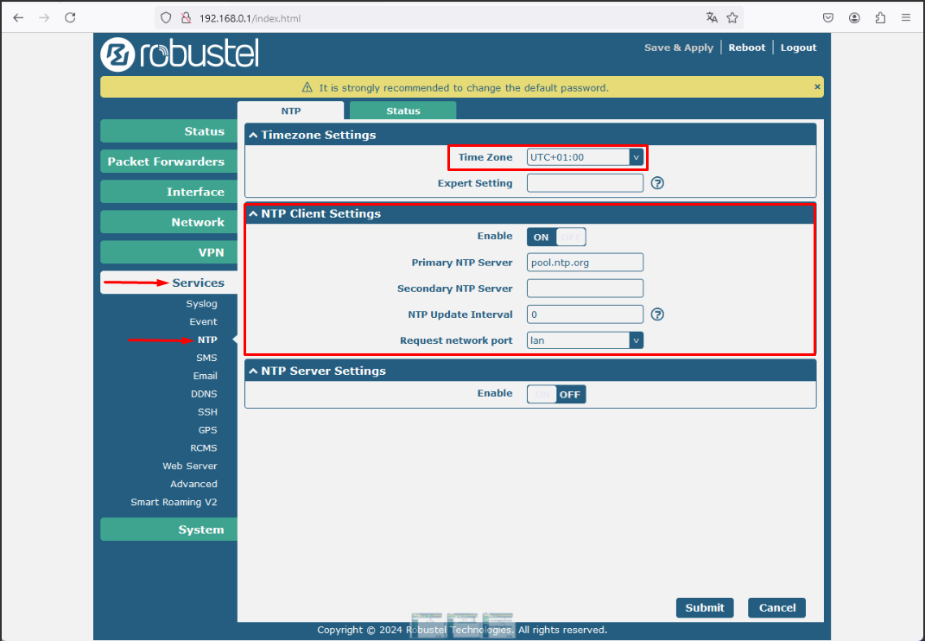
specs/v2-2025/gateway/Images/ntp_config.png
