flipoyo/MOLONARI-hardware/specs/v2-2025/gateway/Images/obtain_gateway_id.png

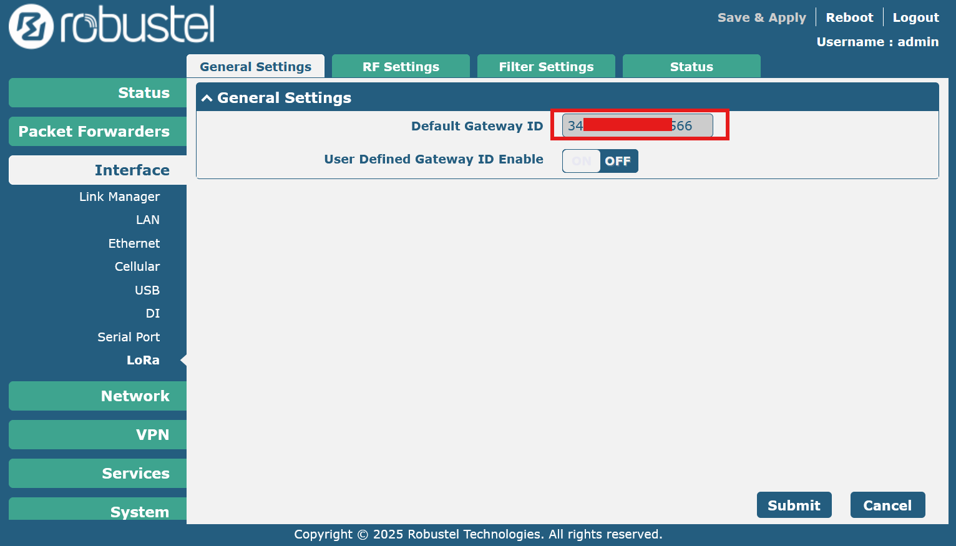
specs/v2-2025/gateway/Images/obtain_gateway_id.png
