flipoyo/MOLONARI-hardware/specs/v2-2025/gateway/Images/off_semtech_2.png

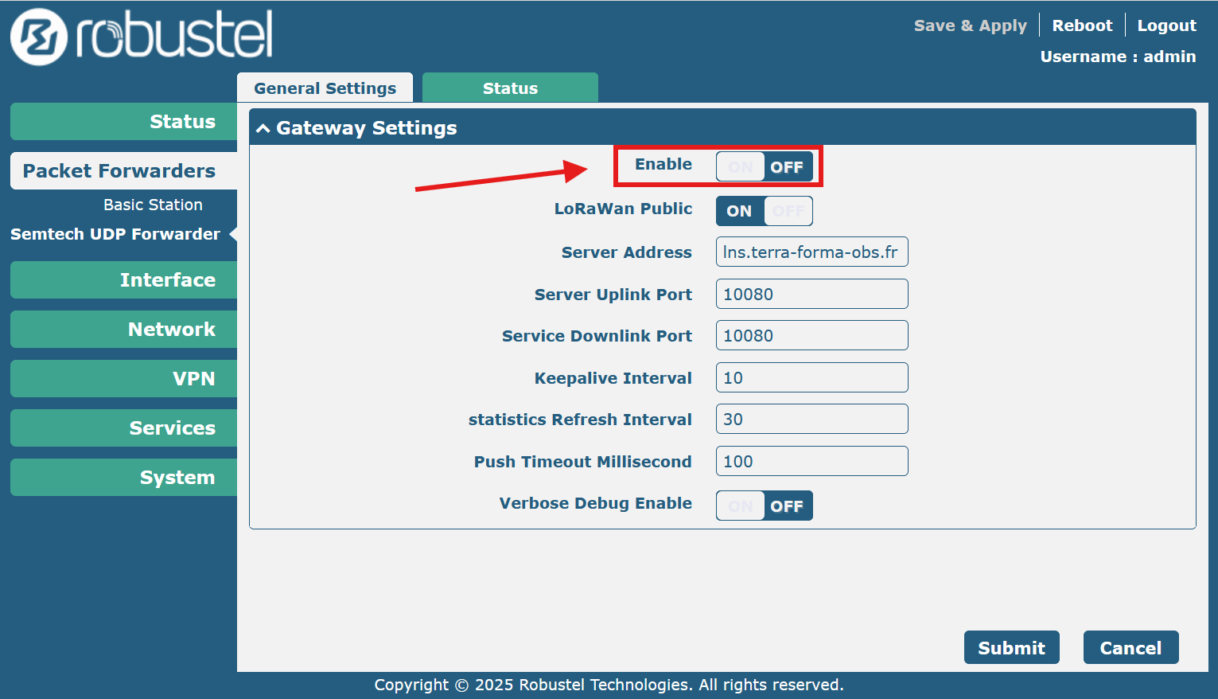
specs/v2-2025/gateway/Images/off_semtech_2.png
