flipoyo/MOLONARI-hardware/specs/v2-2025/gateway/Images/ping_try.png

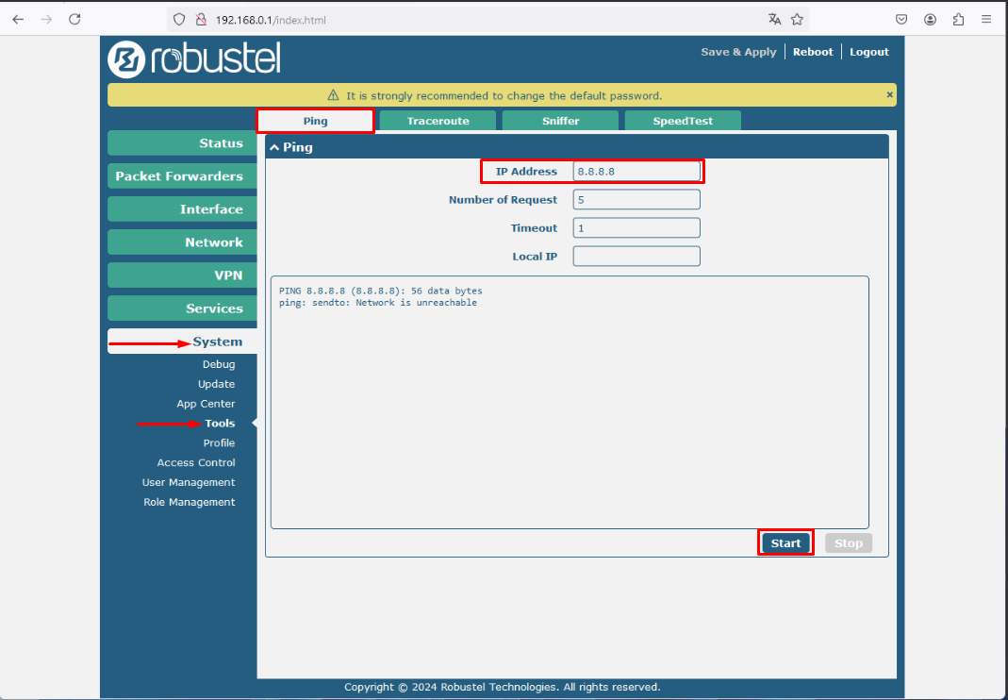
specs/v2-2025/gateway/Images/ping_try.png
