flipoyo/MOLONARI-hardware/specs/v2-2025/gateway/Images/ping_works.png

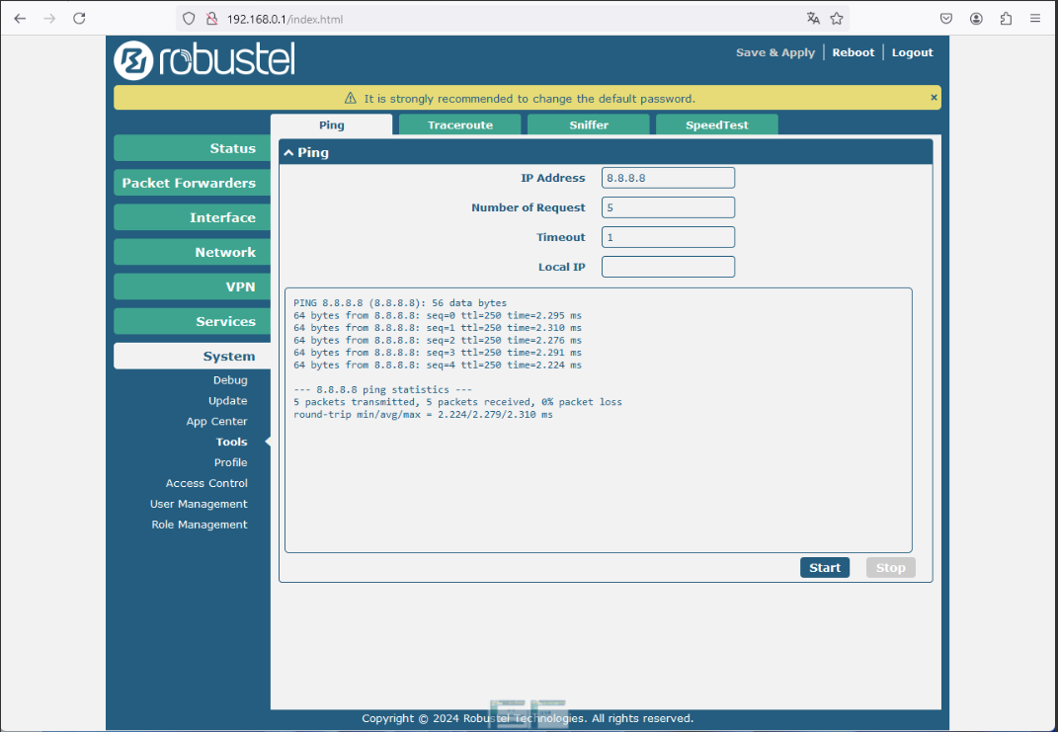
specs/v2-2025/gateway/Images/ping_works.png
