flipoyo/MOLONARI-hardware/specs/v2-2025/gateway/Images/port_assignement.png

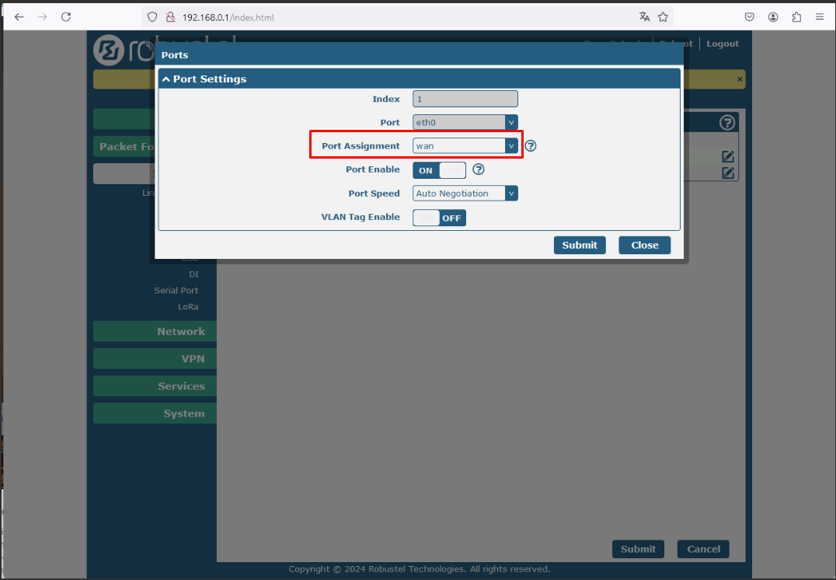
specs/v2-2025/gateway/Images/port_assignement.png
