flipoyo/MOLONARI-hardware/specs/v2-2025/gateway/Images/robustel_adding_certificates.png

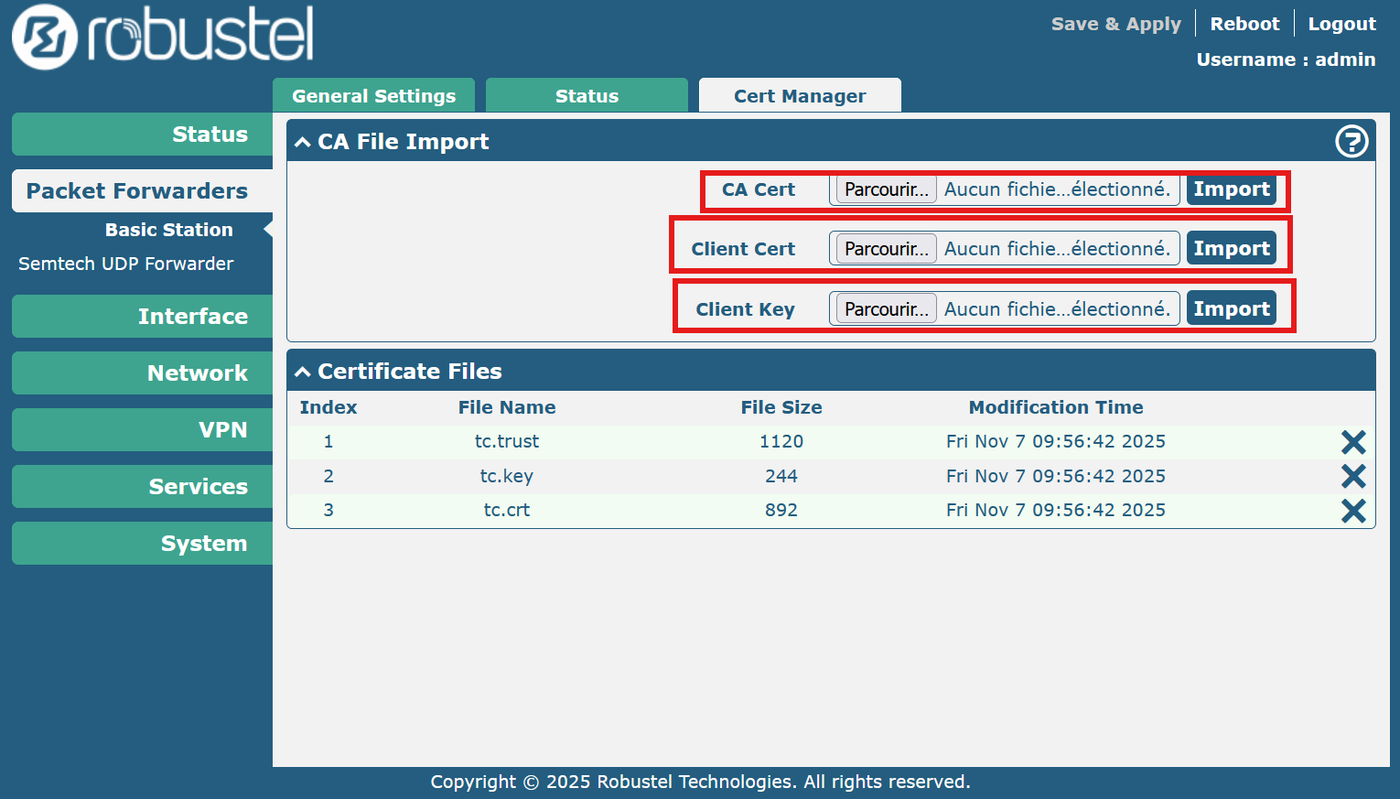
specs/v2-2025/gateway/Images/robustel_adding_certificates.png
