flipoyo/MOLONARI-hardware/specs/v2-2025/gateway/Images/Robustel_login.png

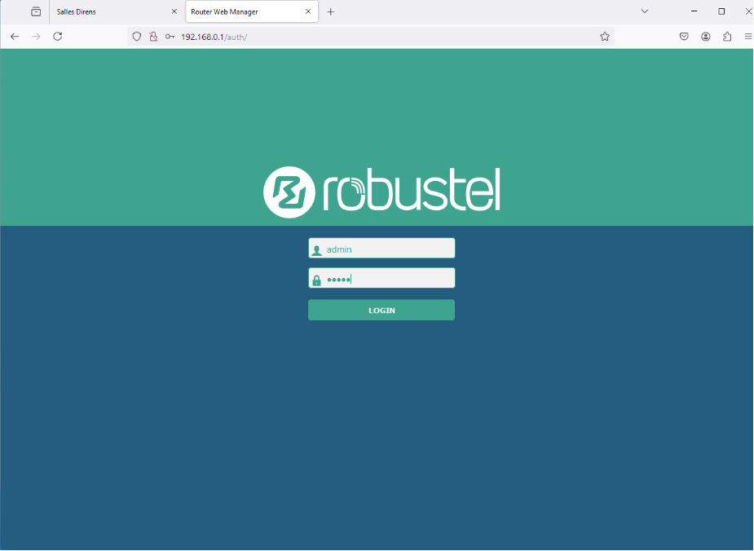
specs/v2-2025/gateway/Images/Robustel_login.png
