flipoyo/MOLONARI-hardware/specs/v2-2025/gateway/Images/save_apply.png

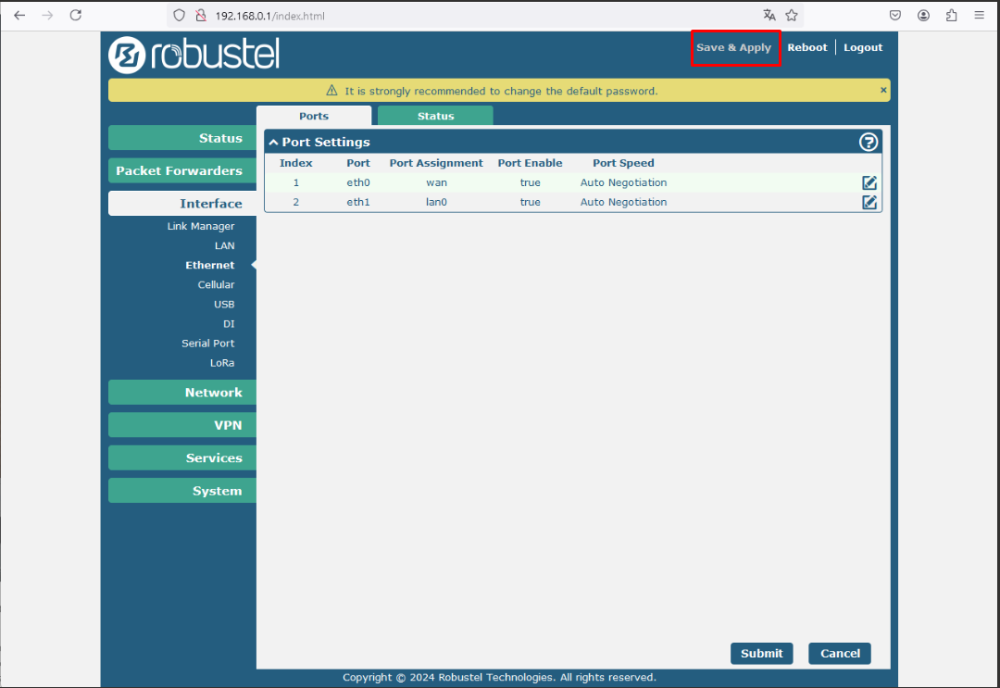
specs/v2-2025/gateway/Images/save_apply.png
