flipoyo/MOLONARI-hardware/specs/v2-2025/gateway/Images/status_internet.png

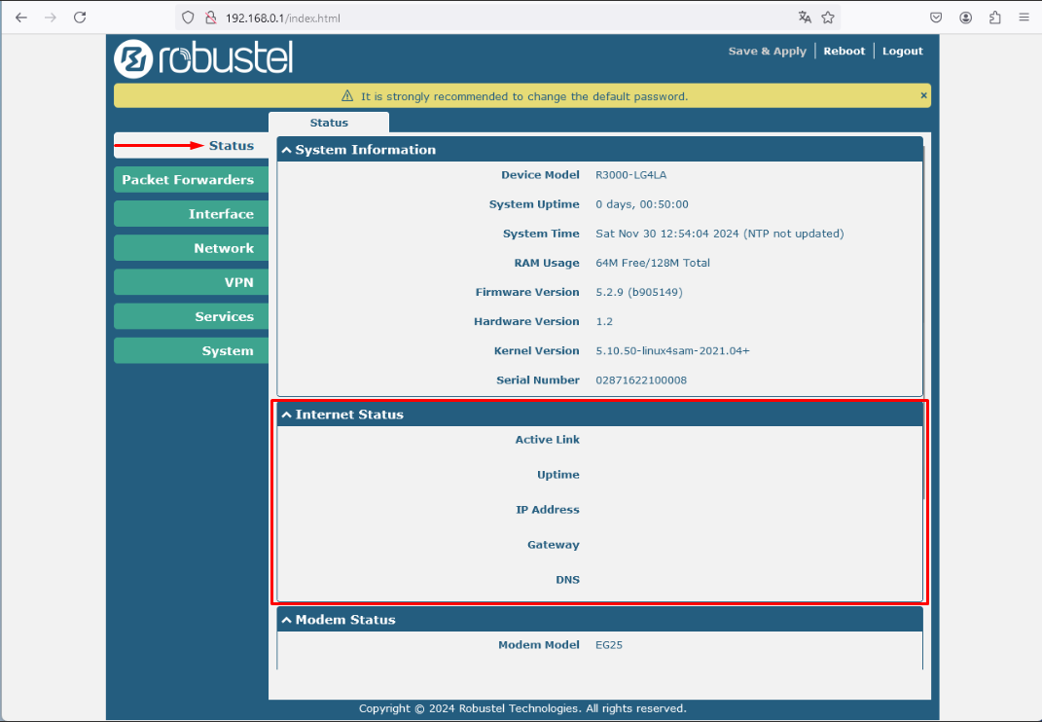
specs/v2-2025/gateway/Images/status_internet.png
