flipoyo/MOLONARI-hardware/specs/v2-2025/gateway/Images/TTN_login.png

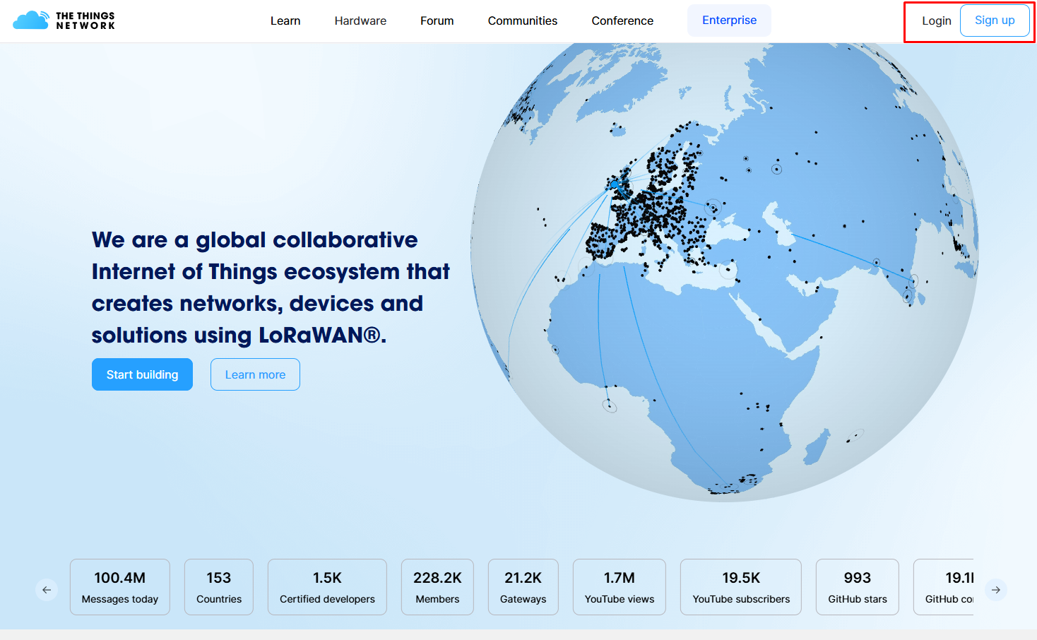
specs/v2-2025/gateway/Images/TTN_login.png
