flipoyo/MOLONARI-hardware/specs/v2-2025/gateway/Images/ttn_login_sesion.png

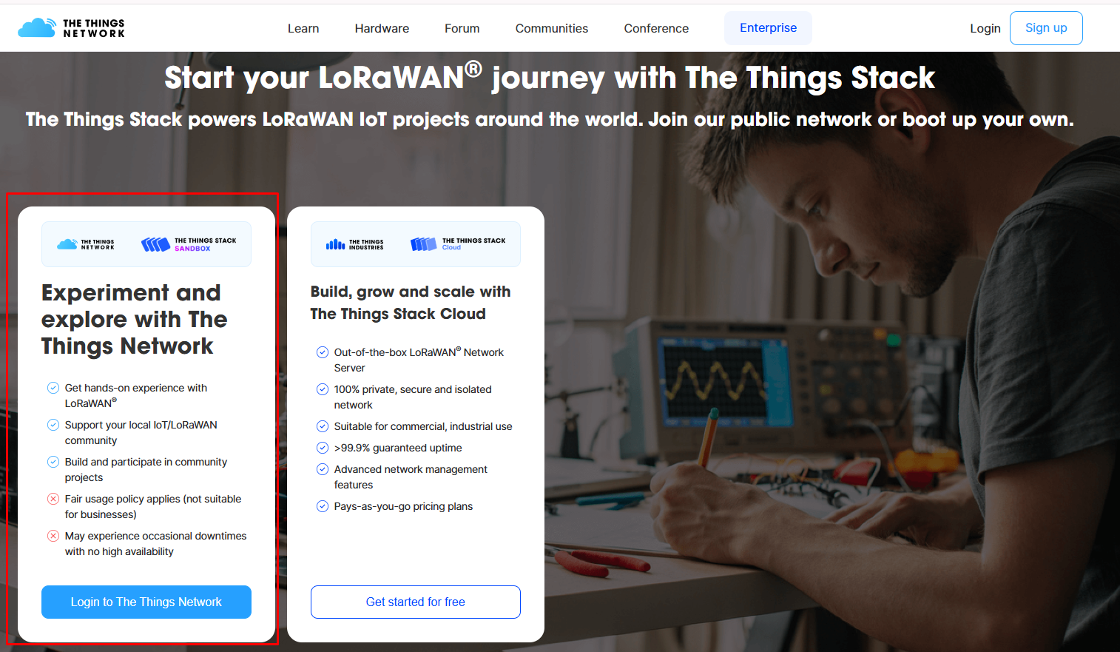
specs/v2-2025/gateway/Images/ttn_login_sesion.png
