flipoyo/MOLONARI-hardware/specs/v2-2025/gateway/Images/Uses_app_robustel.png

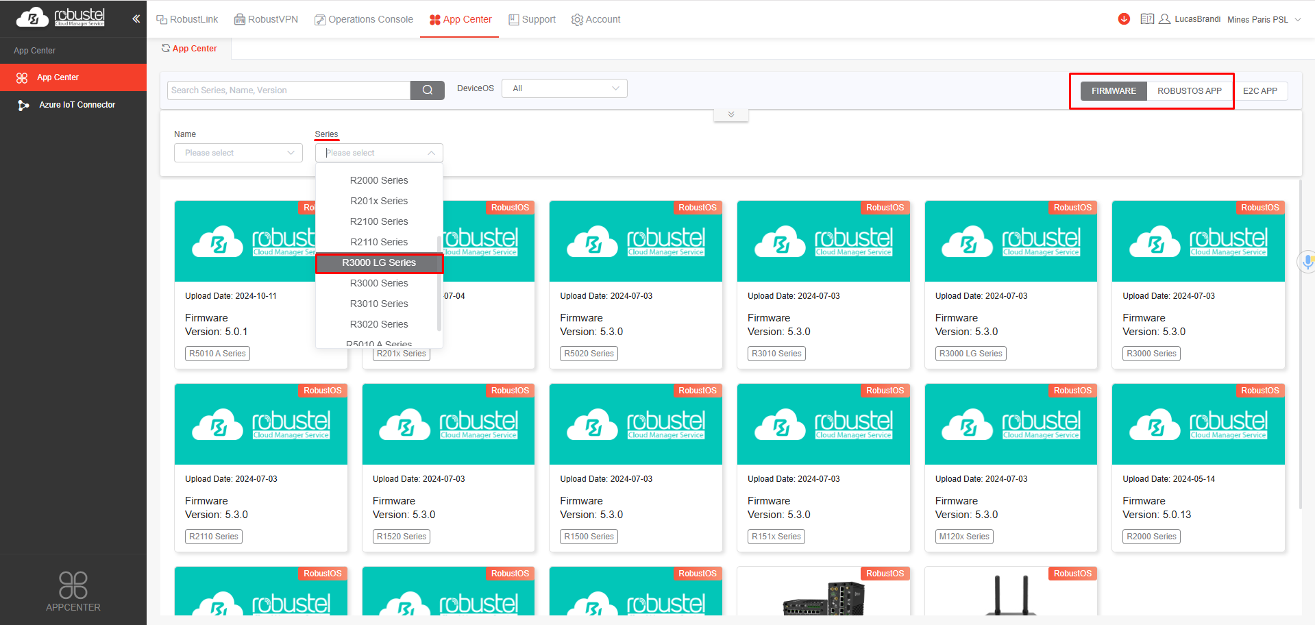
specs/v2-2025/gateway/Images/Uses_app_robustel.png
