flipoyo/MOLONARI-hardware/specs/v2-2025/Images/boite_sans_couvercle_vue_de_dessus - Copie.jpg

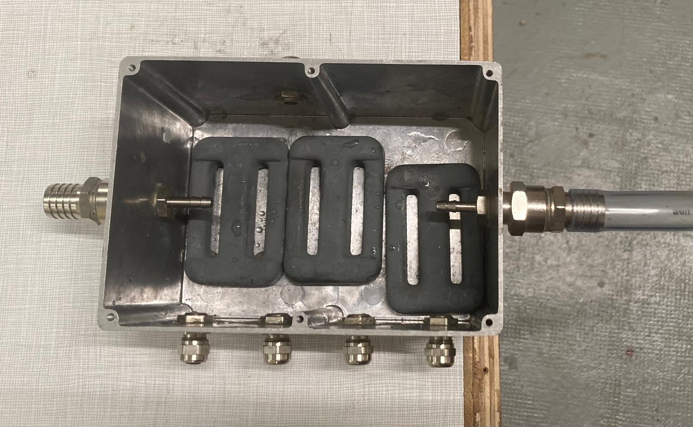
specs/v2-2025/Images/boite_sans_couvercle_vue_de_dessus - Copie.jpg
