flipoyo/MOLONARI-hardware/specs/v2-2025/Images/box_inside_1.jpg

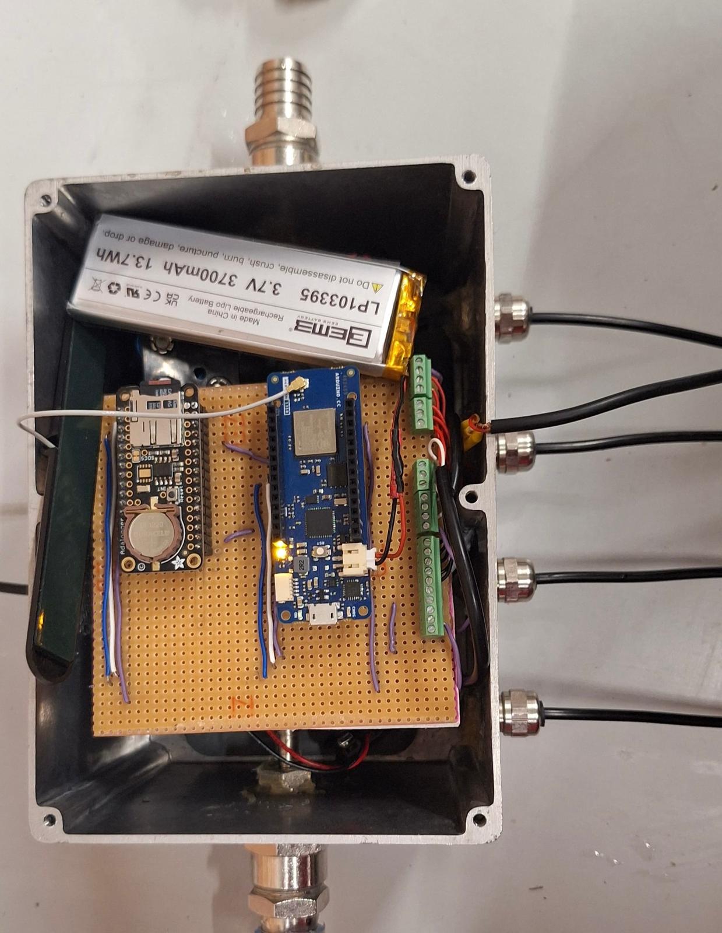
specs/v2-2025/Images/box_inside_1.jpg
