flipoyo/MOLONARI-hardware/specs/v2-2025/Images/box_inside_2.jpg

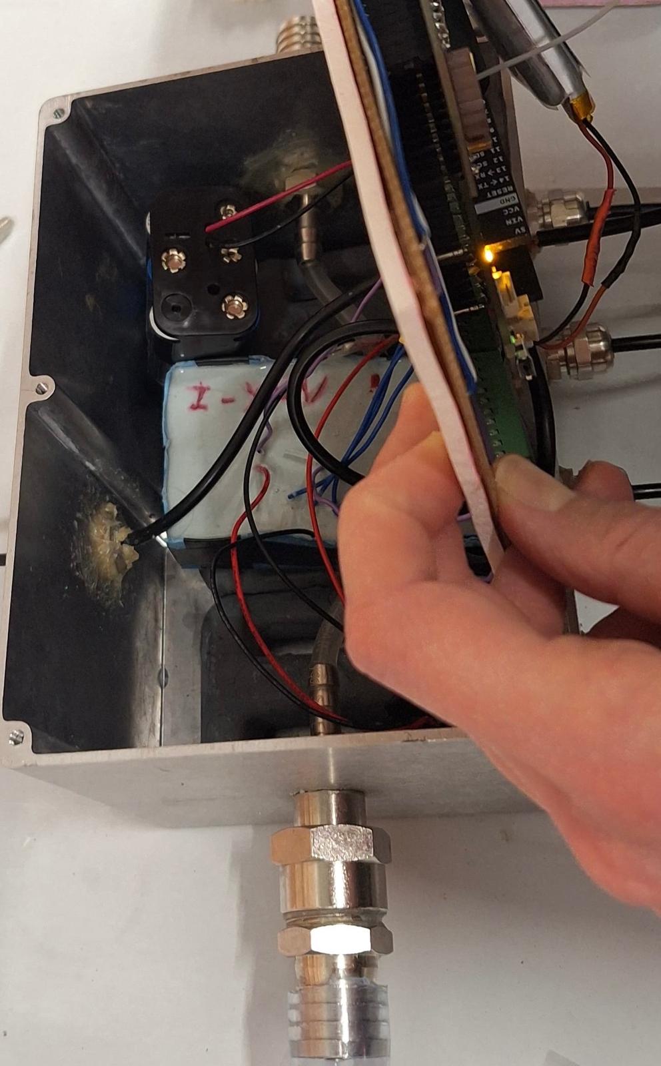
specs/v2-2025/Images/box_inside_2.jpg
