flipoyo/MOLONARI-hardware/specs/v2-2025/Images/box_outside.jpg

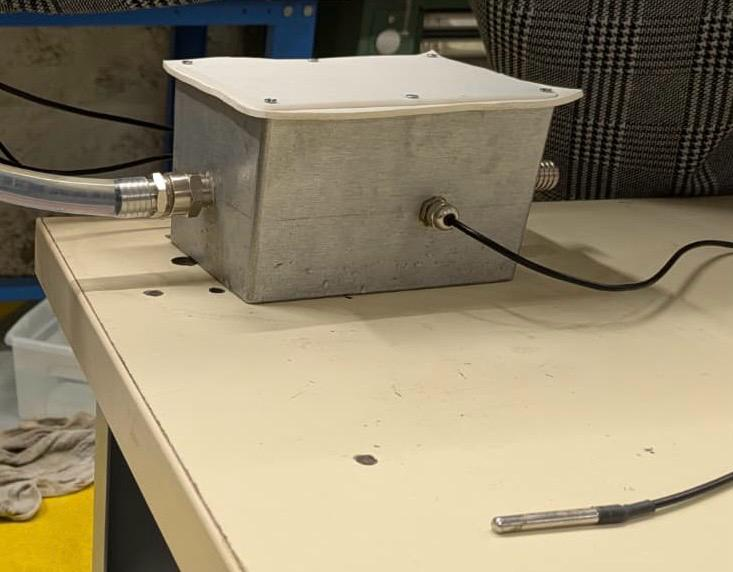
specs/v2-2025/Images/box_outside.jpg
