flipoyo/MOLONARI-hardware/specs/v2-2025/Images/capteur_de_pression_avec_piles.jpg

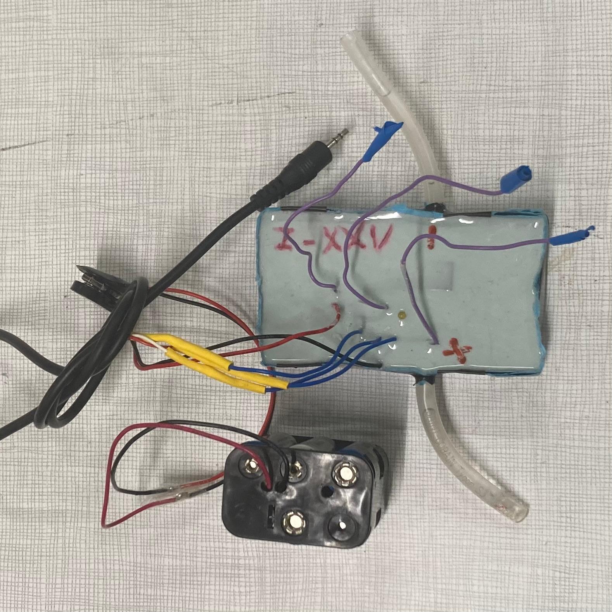
specs/v2-2025/Images/capteur_de_pression_avec_piles.jpg
