flipoyo/MOLONARI-hardware/specs/v2-2025/Images/circuit_capteurs_avec_antenne_et_batterie.jpg

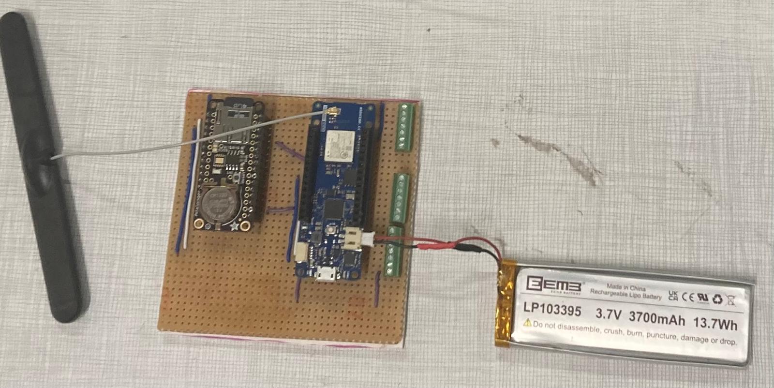
specs/v2-2025/Images/circuit_capteurs_avec_antenne_et_batterie.jpg
