flipoyo/MOLONARI-hardware/specs/v2-2025/Images/complete_molonari_system.jpg

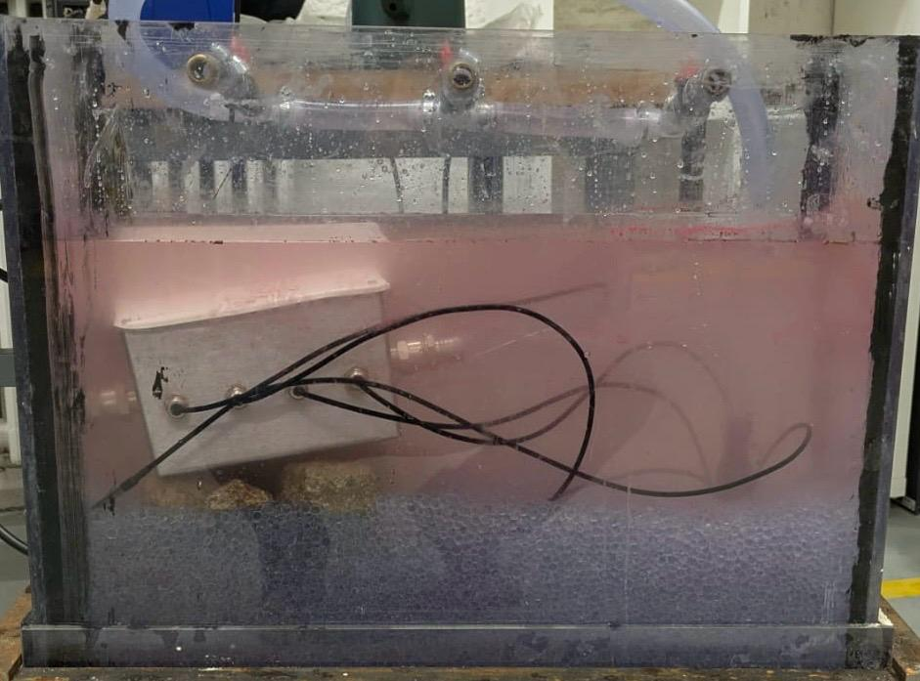
specs/v2-2025/Images/complete_molonari_system.jpg
