flipoyo/MOLONARI-hardware/specs/v2-2025/Images/couvercle_boite_avec_joint_et_vis - Copie.jpg

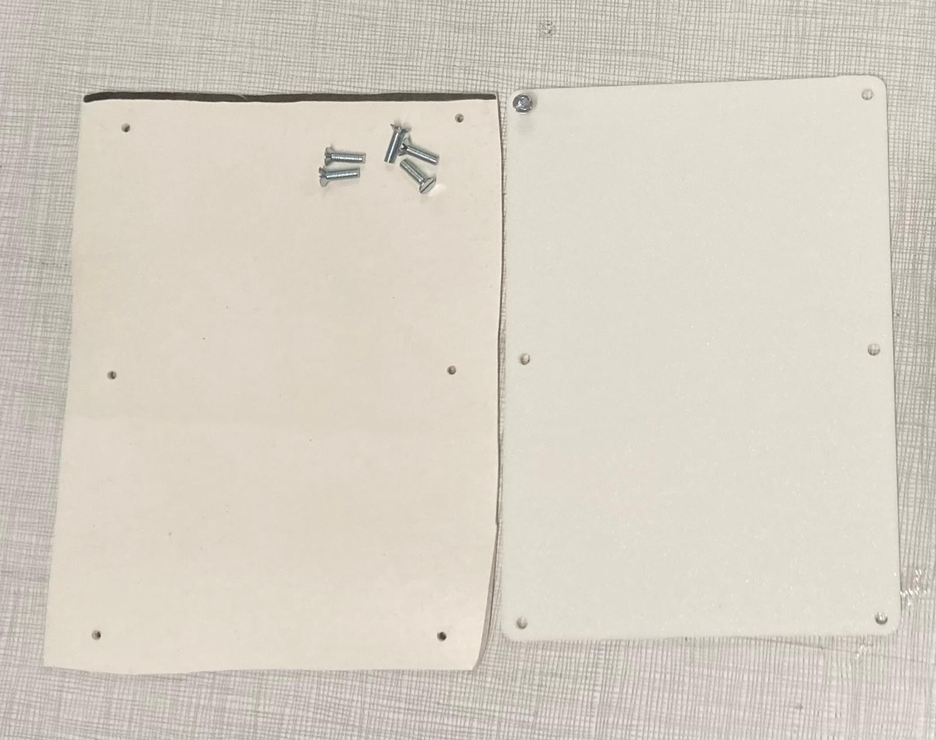
specs/v2-2025/Images/couvercle_boite_avec_joint_et_vis - Copie.jpg
