flipoyo/MOLONARI-hardware/specs/v2-2025/Images/hose_pipe.jpg

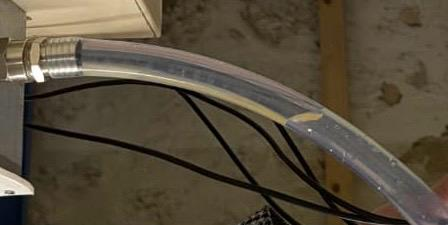
specs/v2-2025/Images/hose_pipe.jpg
