flipoyo/MOLONARI-hardware/specs/v2-2025/Images/tige_complete.jpg

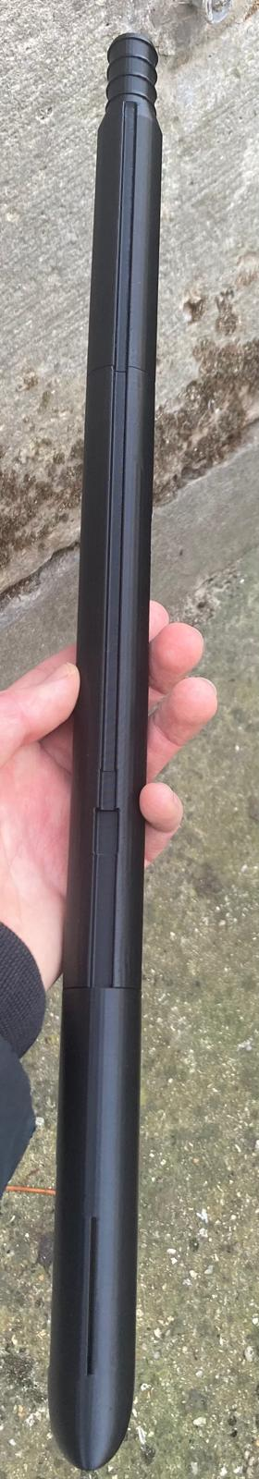
specs/v2-2025/Images/tige_complete.jpg
