flipoyo/MOLONARI-hardware/specs/v2-2025/Images/tige_en_vissage.jpg

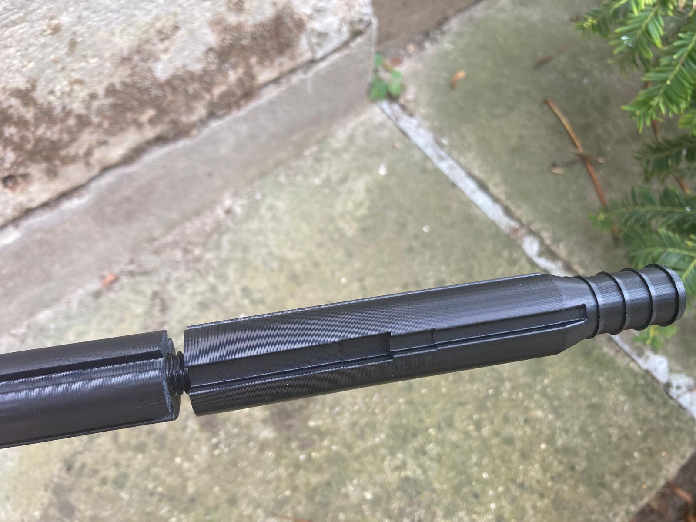
specs/v2-2025/Images/tige_en_vissage.jpg
