flipoyo/MOLONARI-hardware/specs/v2-2025/sensors/box/Images/boite_dessus.jpg

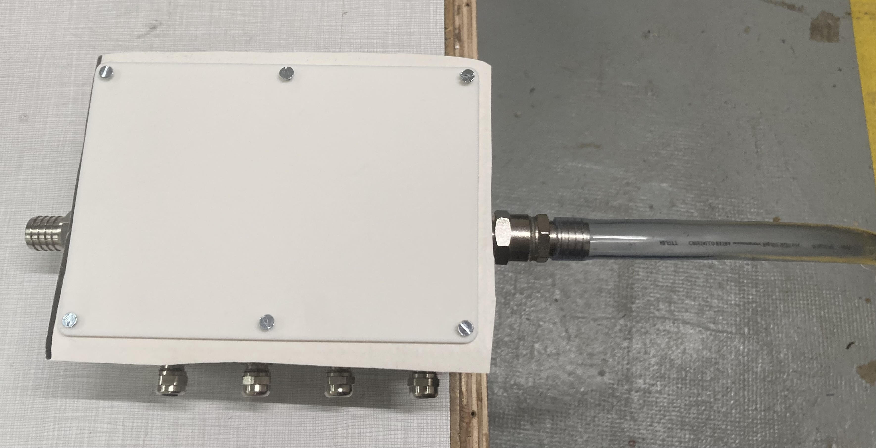
specs/v2-2025/sensors/box/Images/boite_dessus.jpg
