flipoyo/MOLONARI-hardware/specs/v2-2025/sensors/differential pressure sensor/pressure_sensor.jpg

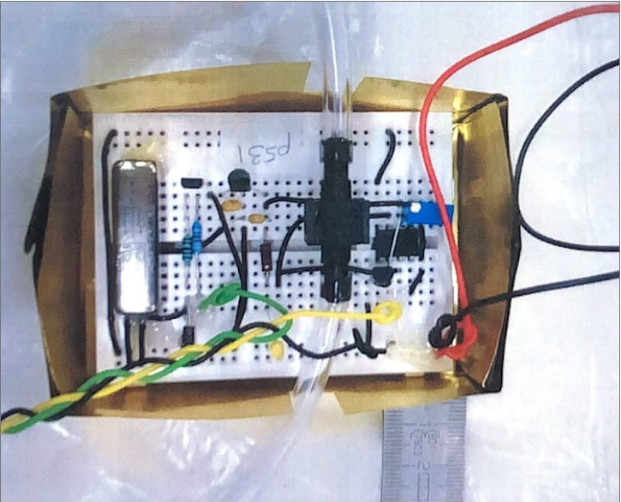
specs/v2-2025/sensors/differential pressure sensor/pressure_sensor.jpg
