flipoyo/MOLONARI-hardware/specs/v2-2025/sensors/shaft/calculation/Images/experience_scheme.jpg

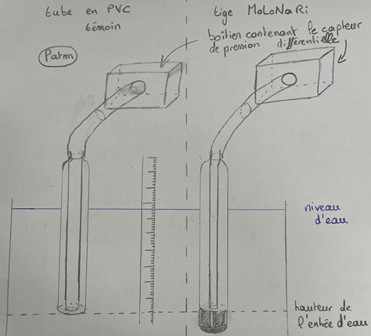
specs/v2-2025/sensors/shaft/calculation/Images/experience_scheme.jpg
