flipoyo/MOLONARI-hardware/specs/v2-2025/sensors/shaft/calculation/Images/shafts_pic_2.jpg

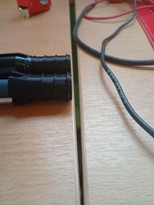
specs/v2-2025/sensors/shaft/calculation/Images/shafts_pic_2.jpg
