flipoyo/MOLONARI-hardware/specs/v2-2025/sensors/temperature sensor/tests_beta_temperature.csv

Titre de tracé : 22395708
# | Date Heure, GMT+01:00 | Temp., °C (LGR S/N: 22395708, SEN S/N: 22395708, LBL: cap1) | Tension, V (LGR S/N: 22395708, SEN S/N: 22395708, LBL: cap2) | Arrêté (LGR S/N: 22395708) | Fin de fichier (LGR S/N: 22395708)
1 | 11/05/25 11:45:42 AM | 22.603 | 1.31178
2 | 11/05/25 11:45:43 AM | 22.603 | 1.31170
3 | 11/05/25 11:45:44 AM | 22.604 | 1.31167
4 | 11/05/25 11:45:45 AM | 22.604 | 1.31163
5 | 11/05/25 11:45:46 AM | 22.606 | 1.31155
6 | 11/05/25 11:45:47 AM | 22.607 | 1.31151
7 | 11/05/25 11:45:48 AM | 22.609 | 1.31144
8 | 11/05/25 11:45:49 AM | 22.607 | 1.31140
9 | 11/05/25 11:45:50 AM | 22.607 | 1.31132
10 | 11/05/25 11:45:51 AM | 22.607 | 1.31125
11 | 11/05/25 11:45:52 AM | 22.607 | 1.31121
12 | 11/05/25 11:45:53 AM | 22.607 | 1.31117
13 | 11/05/25 11:45:54 AM | 22.607 | 1.31113
14 | 11/05/25 11:45:55 AM | 22.609 | 1.31106
15 | 11/05/25 11:45:56 AM | 22.612 | 1.31094
16 | 11/05/25 11:45:57 AM | 22.613 | 1.31083
17 | 11/05/25 11:45:58 AM | 22.603 | 1.31075
18 | 11/05/25 11:45:59 AM | 22.595 | 1.31067
19 | 11/05/25 11:46:00 AM | 22.589 | 1.31056
20 | 11/05/25 11:46:01 AM | 22.583 | 1.31044
21 | 11/05/25 11:46:02 AM | 22.579 | 1.31037
22 | 11/05/25 11:46:03 AM | 22.574 | 1.31022
23 | 11/05/25 11:46:04 AM | 22.570 | 1.31010
24 | 11/05/25 11:46:05 AM | 22.567 | 1.30999
25 | 11/05/25 11:46:06 AM | 22.564 | 1.30987
26 | 11/05/25 11:46:07 AM | 22.562 | 1.30976
27 | 11/05/25 11:46:08 AM | 22.561 | 1.30964
28 | 11/05/25 11:46:09 AM | 22.559 | 1.30949
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
991 | 11/05/25 12:02:12 PM | 30.634 | 1.12879
992 | 11/05/25 12:02:13 PM | 30.490 | 1.13294
993 | 11/05/25 12:02:14 PM | 30.351 | 1.13615
994 | 11/05/25 12:02:15 PM | 30.200 | 1.13935
995 | 11/05/25 12:02:16 PM | 30.046 | 1.14237 | Enregistré | Enregistré
