flipoyo/MOLONARI-hardware/specs/v2-2025/sensors/shaft/building/tige full (sans vis) - fichier à imprimer.stl

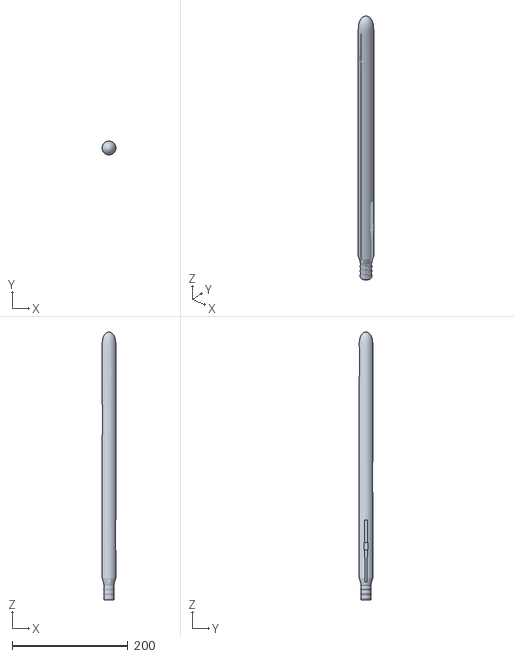
[picture p87: CAD file, 2026-09-18]
specs/v2-2025/sensors/shaft/building/tige full (sans vis) - fichier à imprimer.stl
24.0 x 24.0 x 463.0
