flipoyo/MOLONARI-hardware/Boite/tests/boite_abandon/raccord_cannele.stl

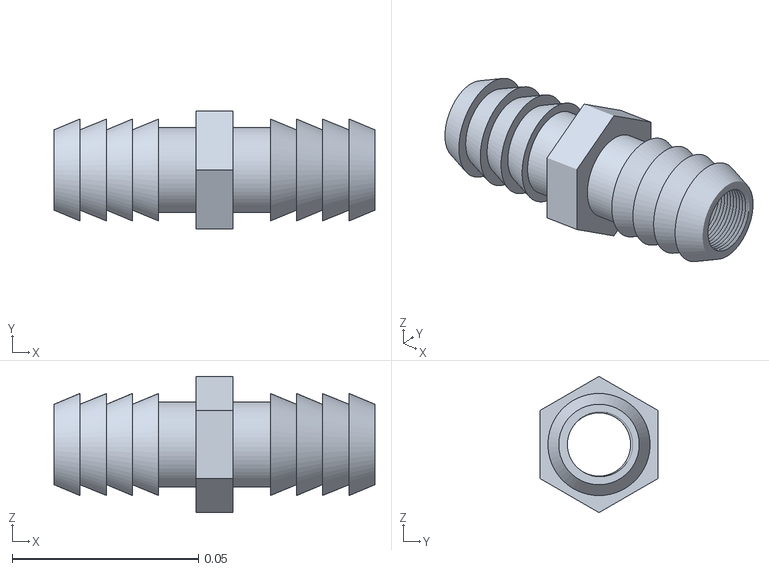
[picture p88: CAD file, 2026-11-13]
Boite/tests/boite_abandon/raccord_cannele.stl
0.0862 x 0.0317 x 0.0366
