flipoyo/MOLONARI-hardware/Boite/tests/pièces_miniature_test/piece_centrale_test.stl

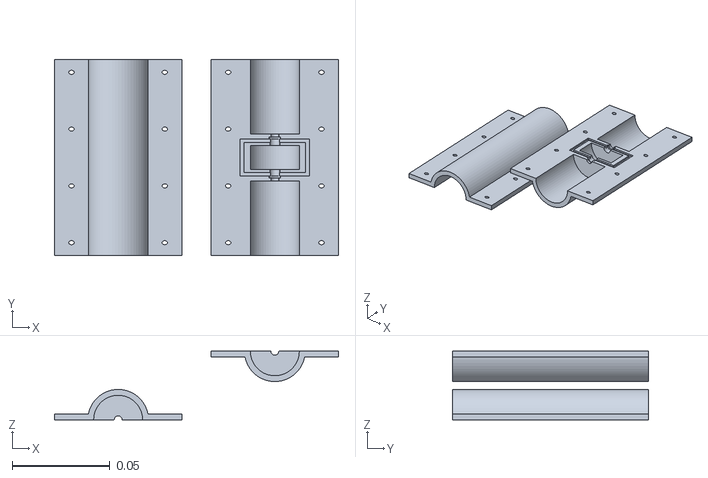
[picture p89: CAD file, 2026-11-13]
Boite/tests/pièces_miniature_test/piece_centrale_test.stl
0.145 x 0.1 x 0.035
