flipoyo/MOLONARI-hardware/specs/v1-until-2024/distributedTemperatureSensor/shaft_2024version/printTemperatureShaft.STL

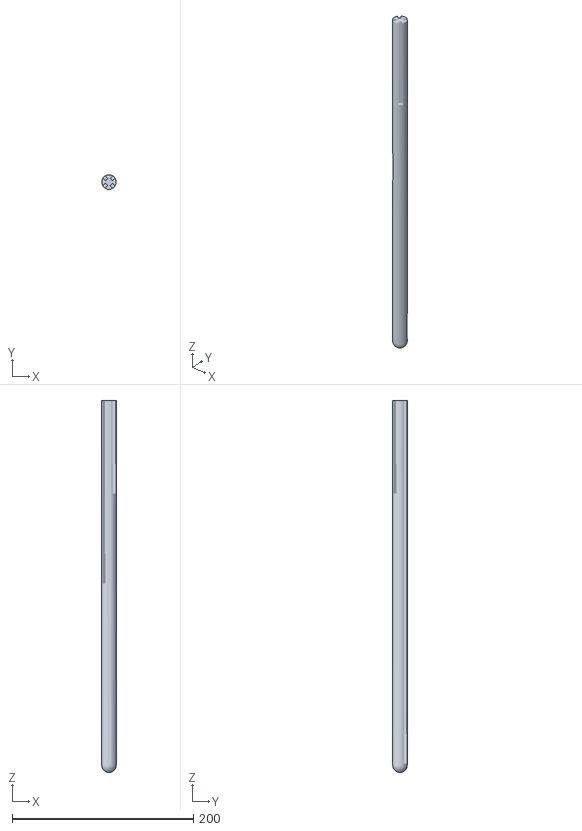
[picture p90: CAD file, 2026-09-18]
specs/v1-until-2024/distributedTemperatureSensor/shaft_2024version/printTemperatureShaft.STL
16.0 x 16.0 x 410.0
