flipoyo/MOLONARI-hardware/specs/v2-2025/sensors/box/cover.stl

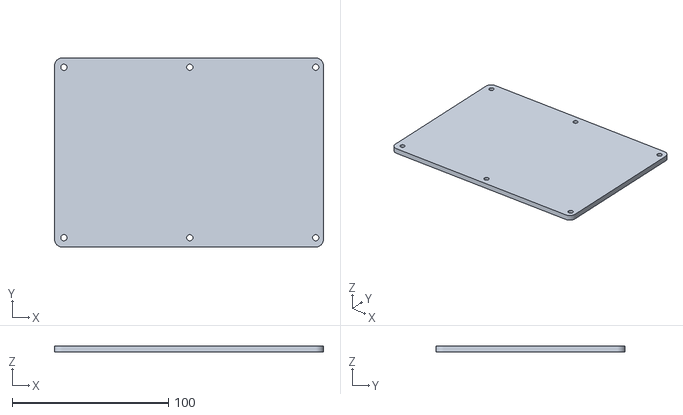
[picture p91: CAD file, 2026-09-18]
specs/v2-2025/sensors/box/cover.stl
172.0 x 121.0 x 4.00
