flipoyo/MOLONARI-hardware/specs/v2-2025/sensors/shaft/building/tige à vis/fichiers stl (pour l'impression)/Embout tige.stl

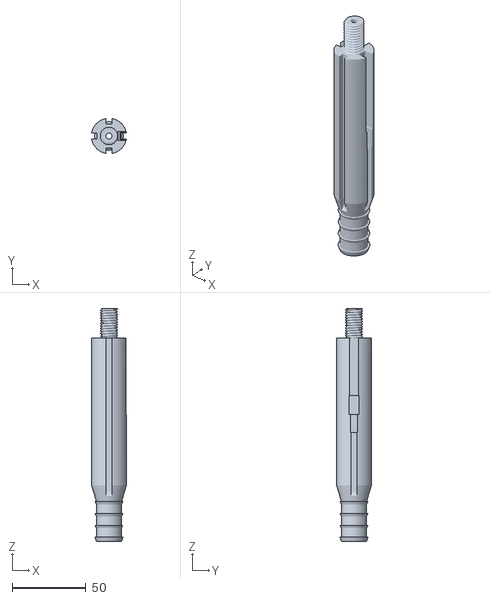
[picture p92: CAD file, 2026-09-18]
specs/v2-2025/sensors/shaft/building/tige à vis/fichiers stl (pour l'impression)/Embout tige.stl
23.7 x 23.7 x 158.0
