flipoyo/MOLONARI-hardware/specs/v2-2025/sensors/shaft/building/tige à vis/modèles fusion/Partie centrale.step

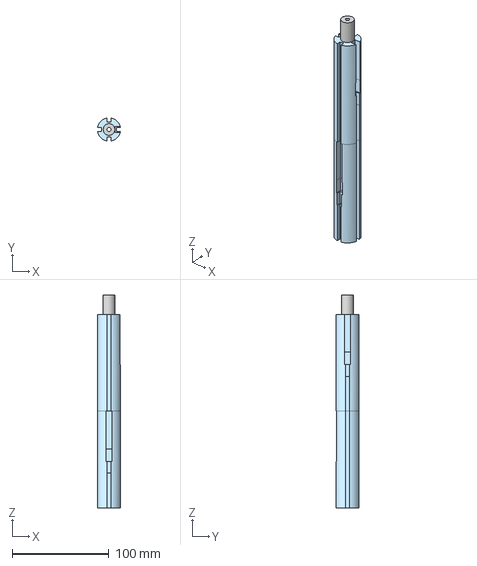
[picture p93: CAD file, 2026-09-18]
specs/v2-2025/sensors/shaft/building/tige à vis/modèles fusion/Partie centrale.step
23.7 x 23.7 x 220.0 mm
