flipoyo/MOLONARI-hardware/specs/v2-2025/sensors/shaft/building/tige à vis/fichiers stl (pour l'impression)/Bout tige.stl

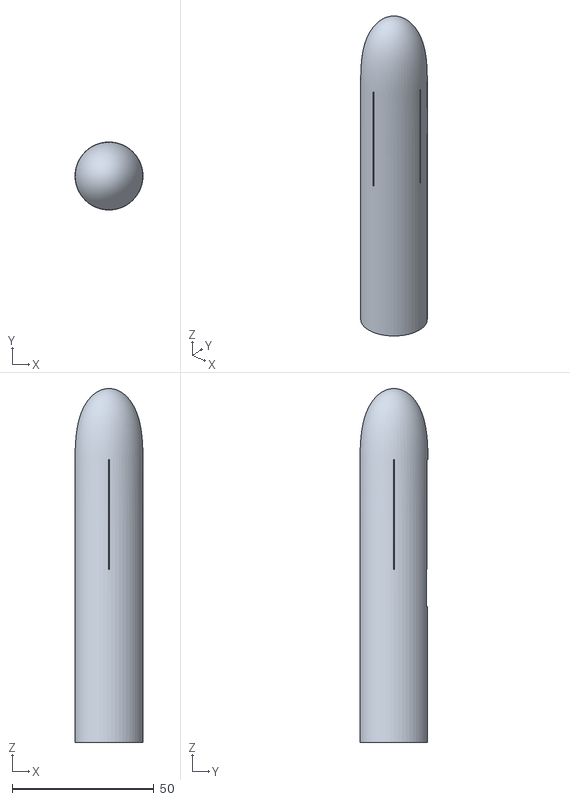
[picture p94: CAD file, 2026-09-18]
specs/v2-2025/sensors/shaft/building/tige à vis/fichiers stl (pour l'impression)/Bout tige.stl
24.0 x 24.0 x 125.0
