flipoyo/MOLONARI-hardware/specs/v2-2025/sensors/shaft/building/tige à vis/modèles fusion/Embout tige.step

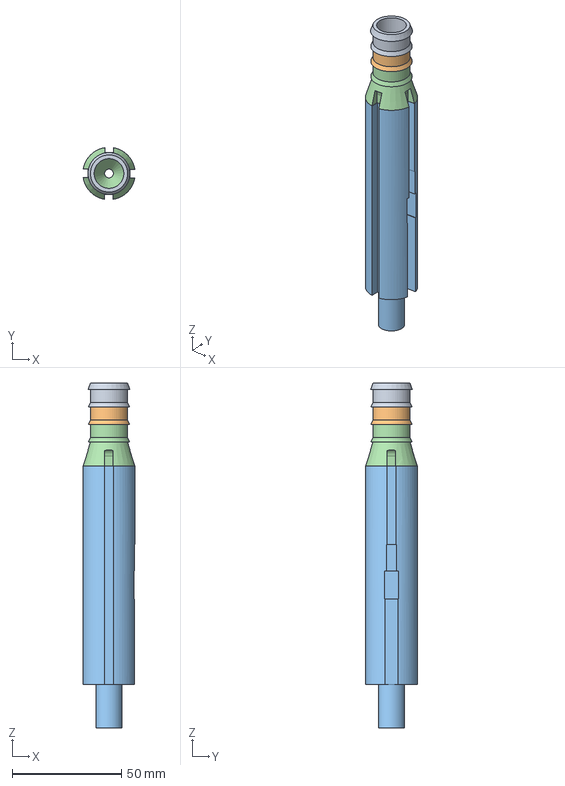
[picture p95: CAD file, 2026-09-18]
specs/v2-2025/sensors/shaft/building/tige à vis/modèles fusion/Embout tige.step
23.7 x 23.7 x 158.0 mm
