flipoyo/MOLONARI-hardware/(list of files, cad)

Other CAD files:
specs/v2-2025/sensors/shaft/building/tige à vis/modèles fusion/Bout tige.step
specs/v2-2025/sensors/shaft/building/tige à vis/fichiers stl (pour l'impression)/Partie centrale.stl
