flipoyo/MOLONARI-hardware/archived/deployment_v1/installationSystem/README.md

# Installation device

A manual pipe raming system is necessary for the installation of the pressure diferential measurment device. Its dimensions are displayed in dimensionPipeRamingSystem.PDF

The device is made of carbon steel.
