flipoyo/MOLONARI-hardware/specs/v2-2025/sensors/differential pressure sensor/calibration/pictures/setup_sampling.jpg

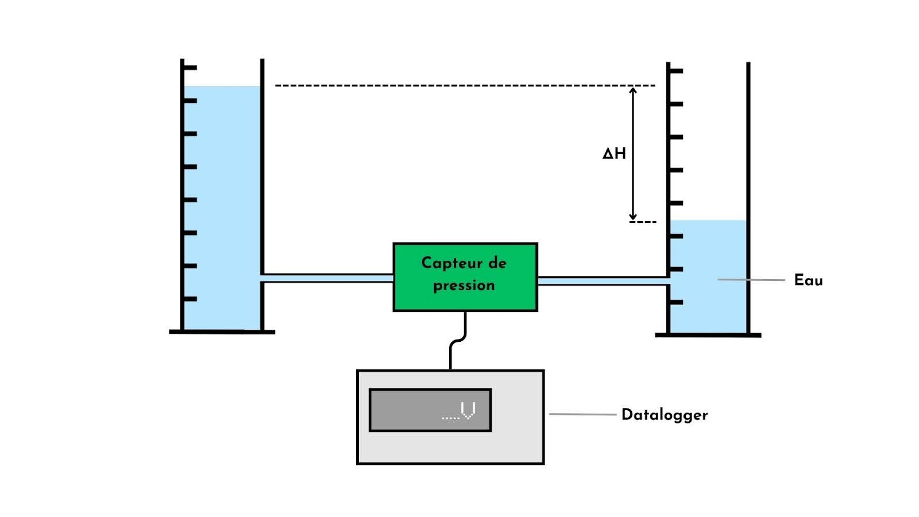
specs/v2-2025/sensors/differential pressure sensor/calibration/pictures/setup_sampling.jpg
