flipoyo/MOLONARI-hardware/specs/v2-2025/sensors/differential pressure sensor/calibration/test_pressure_sensor.xlsx

Tube 1 | Tube 2 | Difference | Voltage | x*y | x^2 | sum(x)= | 18.9159 | dH (LSM) | dP
4.9 | 0 | -4.9 | 1.514 | -7.4186 | 2.292196 | sum(y)= | 33.3 | -5.698855972 | -557.9396553
4.9 | 4.4 | -0.5 | 1.648 | -0.824 | 2.715904 | sum*sum= | 629.89947 | -0.01234741609 | -1.208858956
4.9 | 5 | 0.1 | 1.659 | 0.1659 | 2.752281 | sum(x^2)= | 32.61304181 | 0.4544555251 | 44.49292284
4.1 | 4.4 | 0.3 | 1.666 | 0.4998 | 2.775556 | n= | 11 | 0.7515119422 | 73.57587489
1.7 | 4.4 | 2.7 | 1.733 | 4.6791 | 3.003289 | sum(xy)= | 60.85985 | 3.59476622 | 351.9412731
5.5 | 8.8 | 3.3 | 1.724 | 5.6892 | 2.972176 | m= | 42.43663102 | 3.212836541 | 314.5489062
5.3 | 10.4 | 5.1 | 1.762 | 8.9862 | 3.104644 | c= | -69.94791533 | 4.82542852 | 472.4277887
4.9 | 10.4 | 5.5 | 1.7709 | 9.73995 | 3.13608681 |  |  | 5.203114536 | 509.4046849
1.7 | 8.8 | 7.1 | 1.812 | 12.8652 | 3.283344 |  |  | 6.94726007 | 680.1631605
3.1 | 10.4 | 7.3 | 1.814 | 13.2422 | 3.290596 |  |  | 7.032133332 | 688.4725754
0.6 | 7.9 | 7.3 | 1.813 | 13.2349 | 3.286969 | dH=42.43663*V-69.9479 (cm) |  | 6.989696701 | 684.3178679
 |  |  |  |  |  | dP=998*9.81*dH/100 (pascals)
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
