flipoyo/MOLONARI-hardware/docs/Images/field-test.png

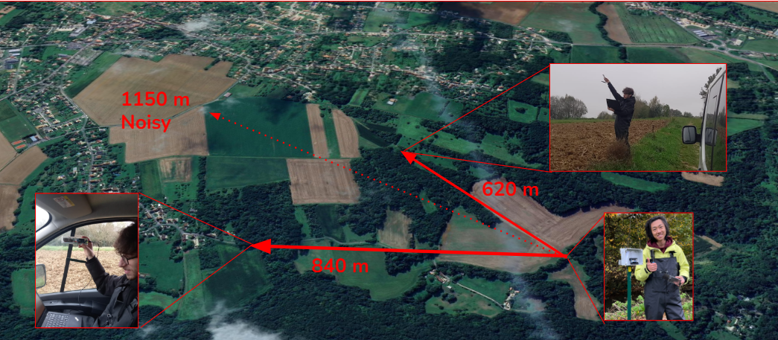
docs/Images/field-test.png
