flipoyo/MOLONARI-hardware/specs/v2-2025/gateway/Images/debug.png

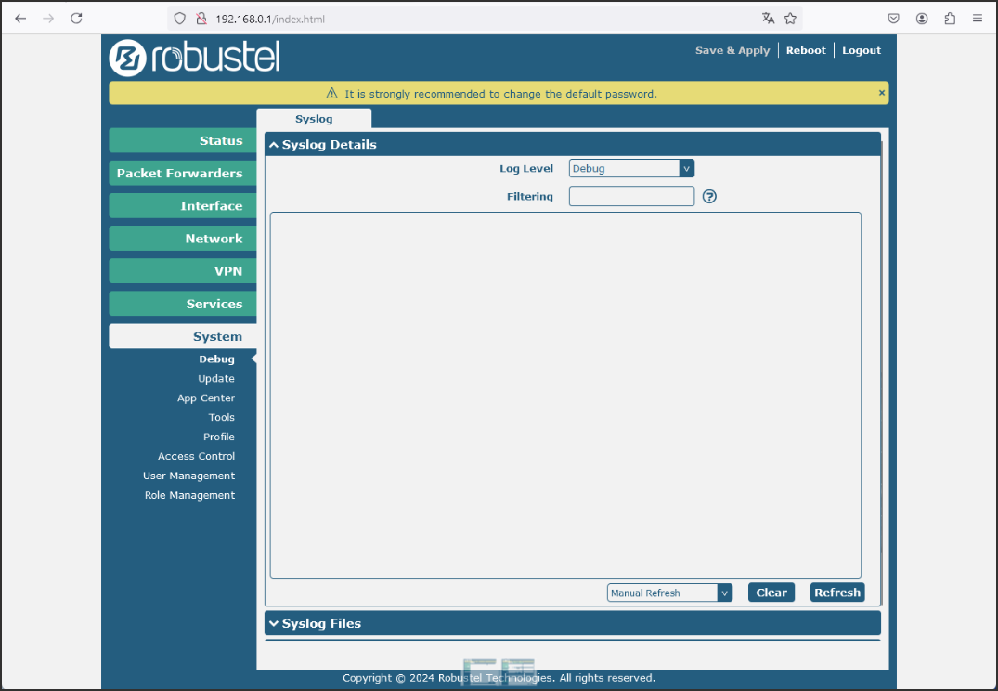
specs/v2-2025/gateway/Images/debug.png
