flipoyo/MOLONARI-hardware/archived/deployment_v1/installationSystem/dimensionPipeRamingSystem.PDF

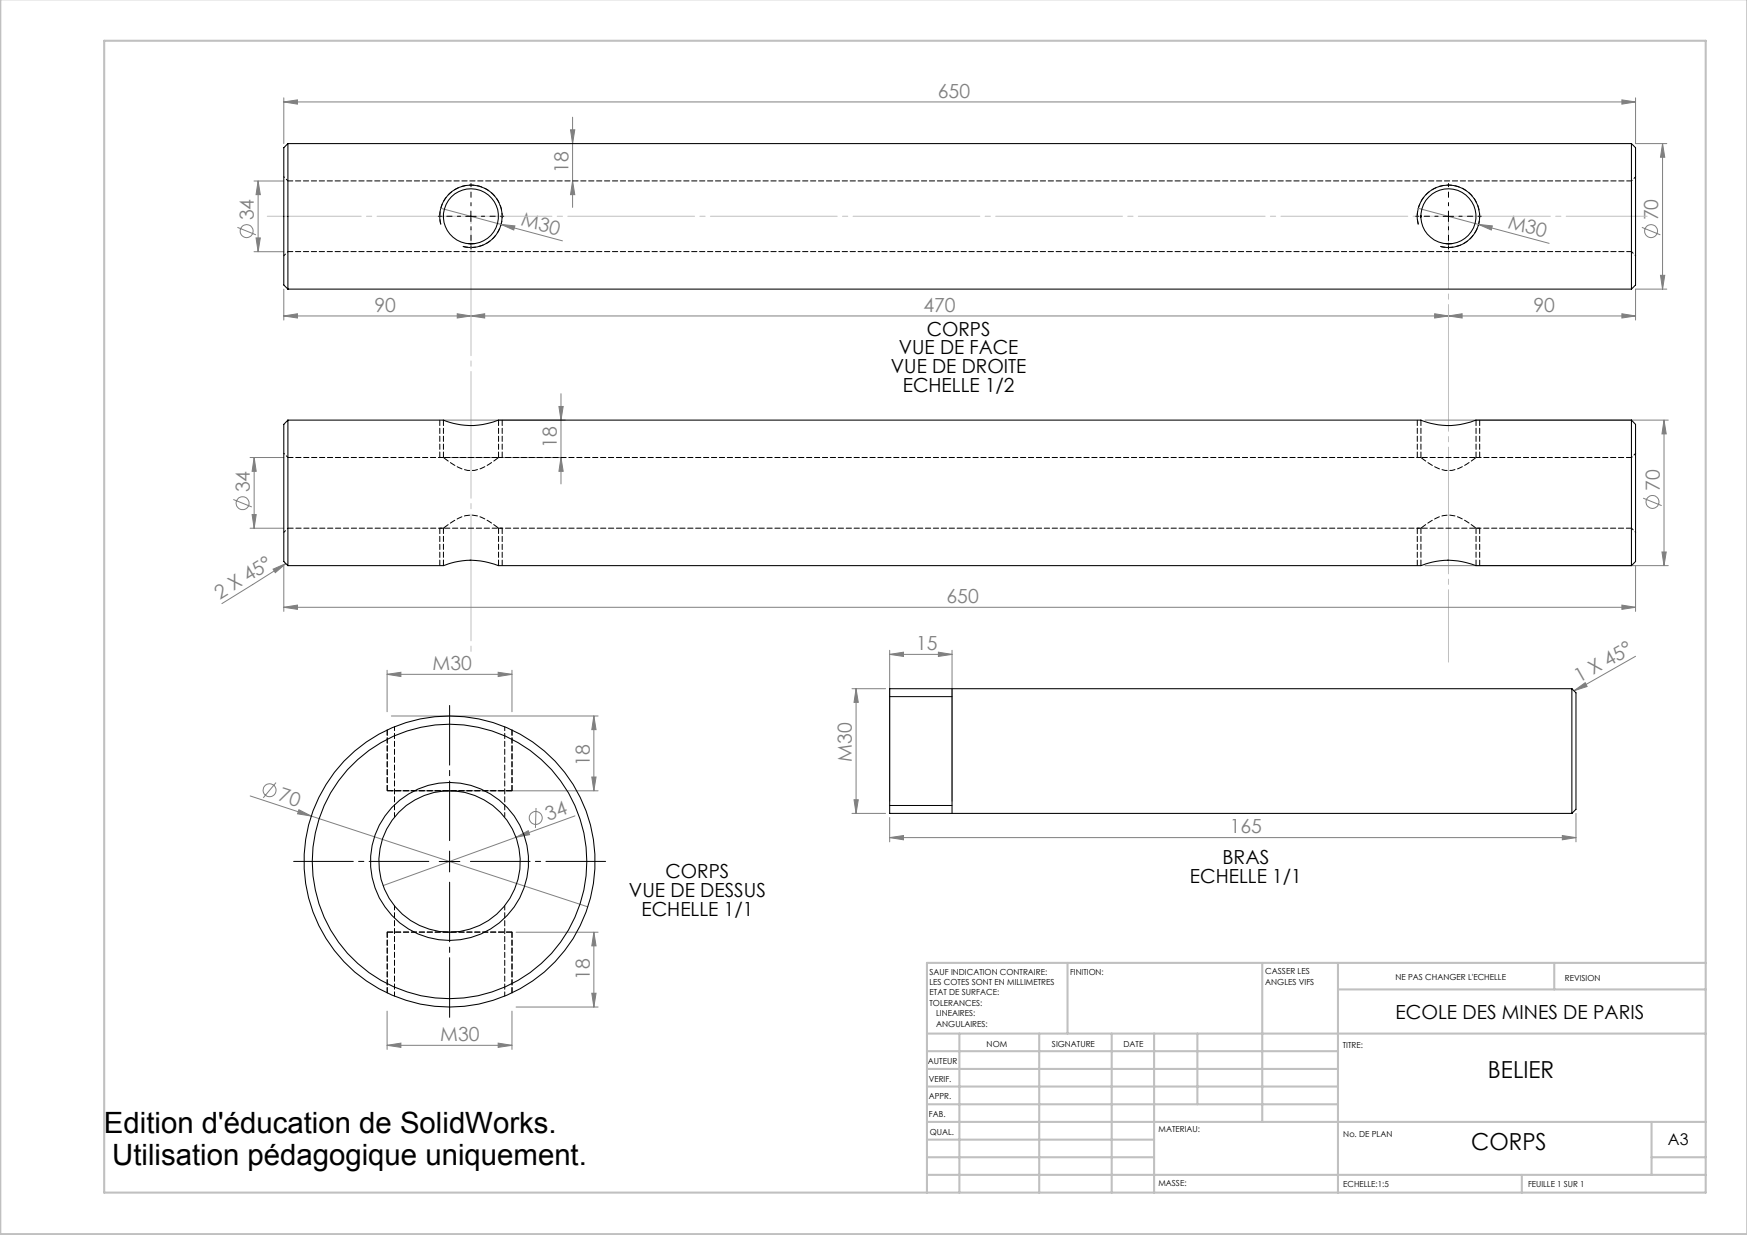
[picture p109: page 1]
BRAS CORPS; ECHELLE 1/1 VUE DE DESSUS; ECHELLE 1/1; ECHELLE:1:5; FEUILLE 1 SUR 1; NE PAS CHANGER L'ECHELLE; REVISION; CASSER LES ANGLES VIFS; SAUF INDICATION CONTRAIRE:; FINITION:

CORPS
VUE DE FACE
VUE DE DROITE
ECHELLE 1/2

LES COTES SONT EN MILLIMETRES
ETAT DE SURFACE:
TOLERANCES:
LINEAIRES:
ANGULAIRES:

ECOLE DES MINES DE PARIS

NOM | SIGNATURE | DATE | | | | TITRE: BELIER

AUTEUR
VERIF.
APPR.
FAB.
QUAL. | | | | MATERIAU: | No. DE PLAN CORPS | A3

Edition d'éducation de SolidWorks.
Utilisation pédagogique uniquement.

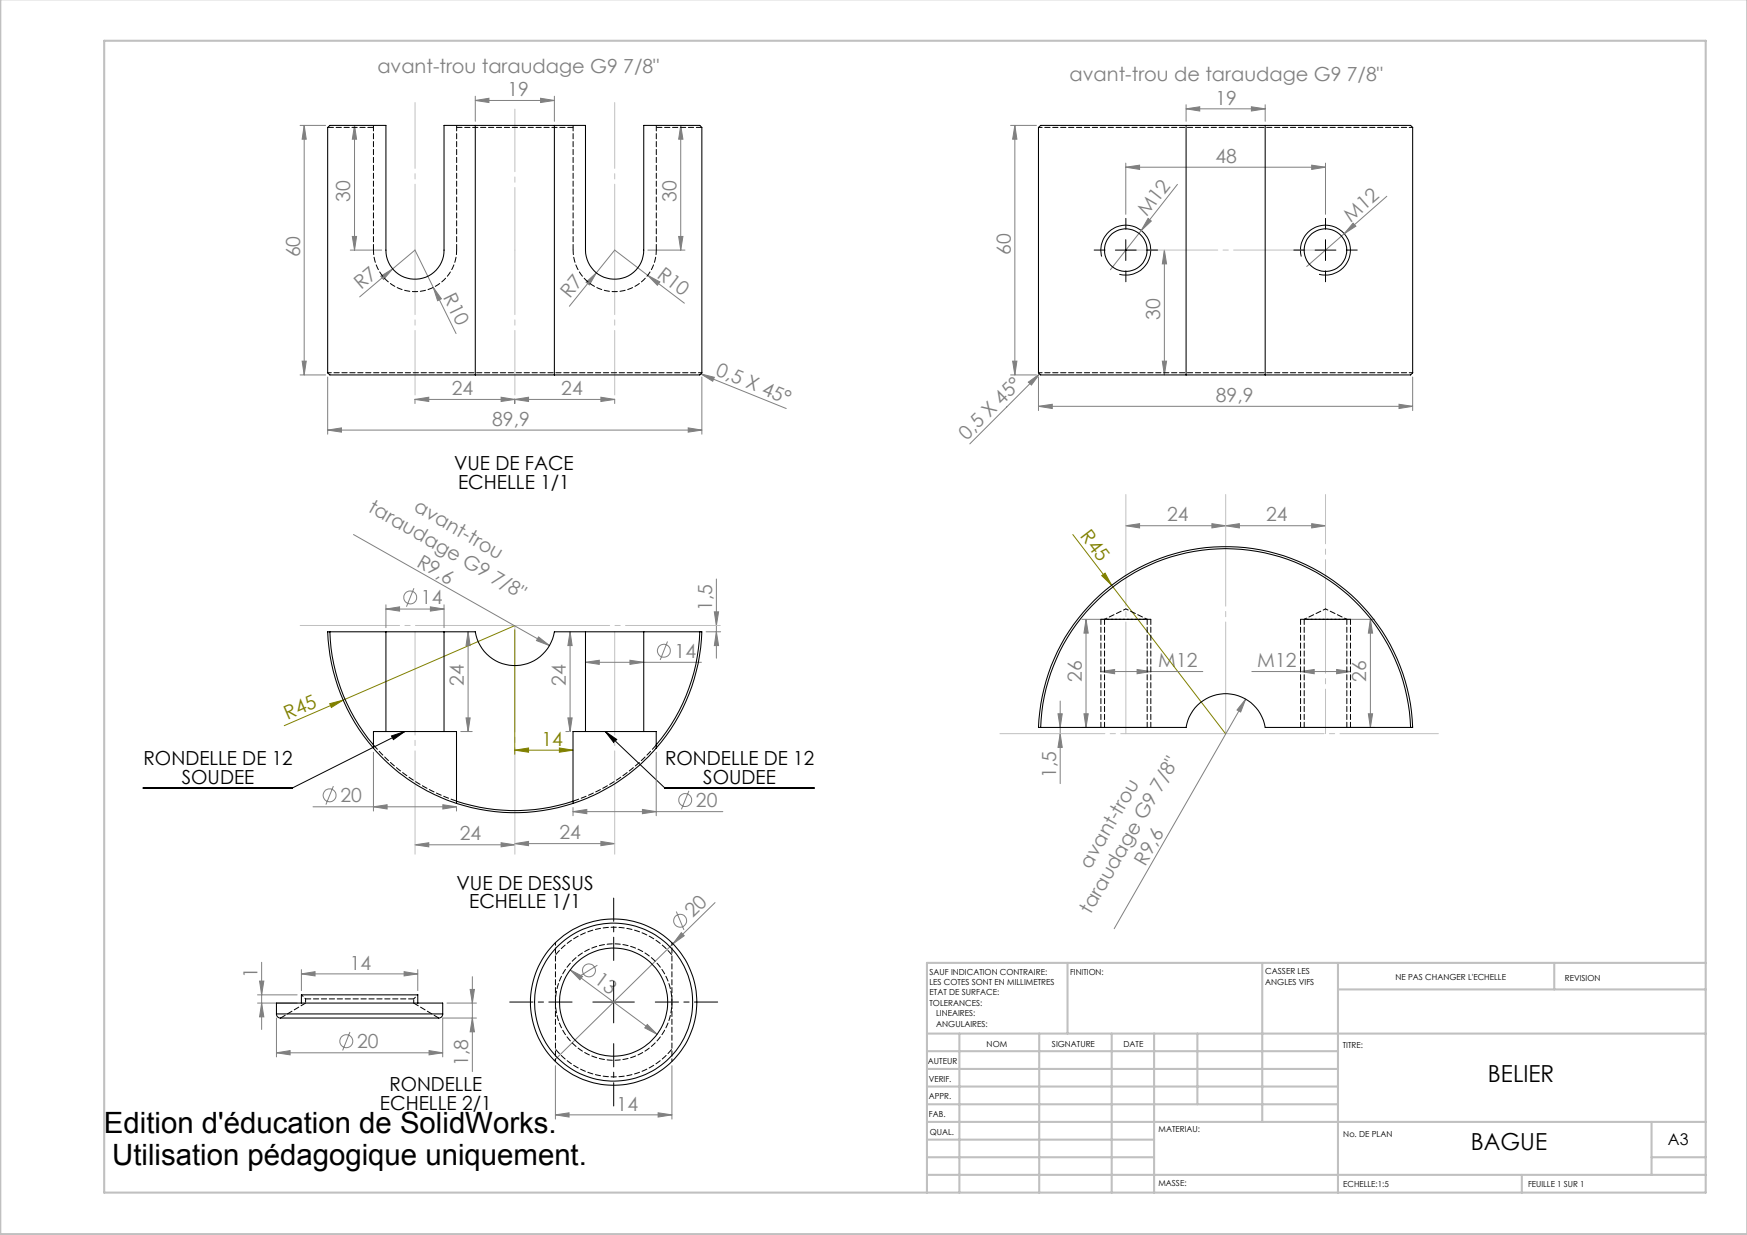
[picture p110: page 2]
taraudage G9 7/8" R9,6 24; RONDELLE DE 12; taraudage G9 7/8"; VUE DE FACE ECHELLE 1/1; ECHELLE 2/1; ECHELLE:1:5; FEUILLE 1 SUR 1; NE PAS CHANGER L'ECHELLE; REVISION; CASSER LES ANGLES VIFS; SAUF INDICATION CONTRAIRE:; FINITION:

avant-trou taraudage G9 7/8"

avant-trou de taraudage G9 7/8"

VUE DE DESSUS
ECHELLE 1/1

LES COTES SONT EN MILLIMETRES
ETAT DE SURFACE:
TOLERANCES:
LINEAIRES:
ANGULAIRES:

VERIF.
APPR.
FAB.
QUAL. | MATERIAU: | No. DE PLAN BAGUE | A3

Edition d'éducation de SolidWorks.
Utilisation pédagogique uniquement.
