flipoyo/MOLONARI-hardware/(commit log)

2026-09-18 Initial repo for MOLONARI1D hardware
    [Bout tige.step, Bout tige.stl, Embout tige.step, Embout tige.stl, Partie centrale.step, Partie centrale.stl, conf.csv, cover.stl]
2026-10-07 rm firmware from branch CGS-MOLO and adding install.cgs
    [conf.csv]
2026-11-05 MOLO-HRDW under @cgs: the gate mounts are ignored
