flipoyo/MOLONARI-hardware/specs/v2-2025/sensors/differential pressure sensor/calibration/pictures/Climate chamber.png

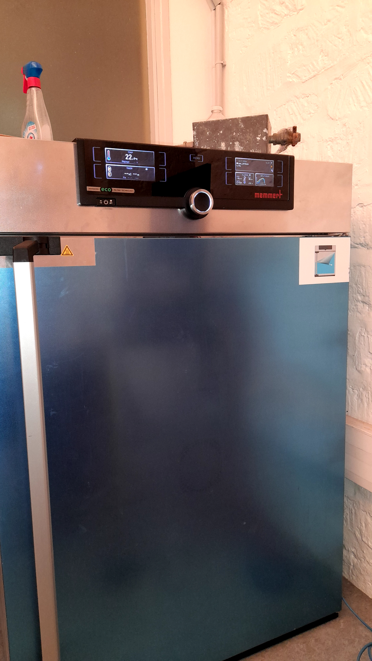
[picture p99: specs/v2-2025/sensors/differential pressure sensor/calibration/pictures/Climate chamber.png]
specs/v2-2025/sensors/differential pressure sensor/calibration/pictures/Climate chamber.png
