flipoyo/MOLONARI-hardware/specs/v2-2025/sensors/differential pressure sensor/calibration/pictures/status_bar.png

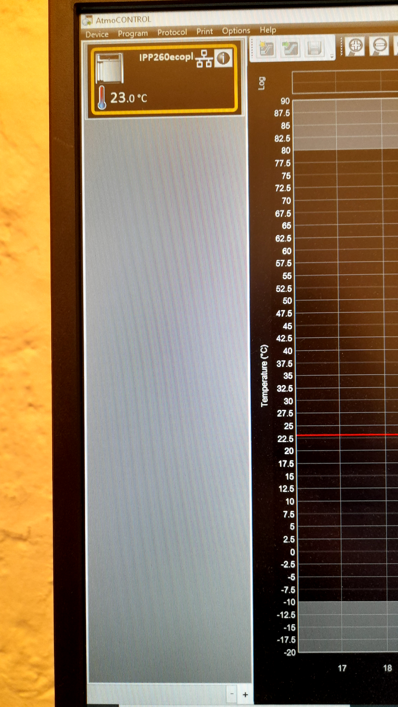
[picture p101: specs/v2-2025/sensors/differential pressure sensor/calibration/pictures/status_bar.png]
specs/v2-2025/sensors/differential pressure sensor/calibration/pictures/status_bar.png
