flipoyo/MOLONARI-hardware/specs/v2-2025/sensors/differential pressure sensor/calibration/pictures/drag.png

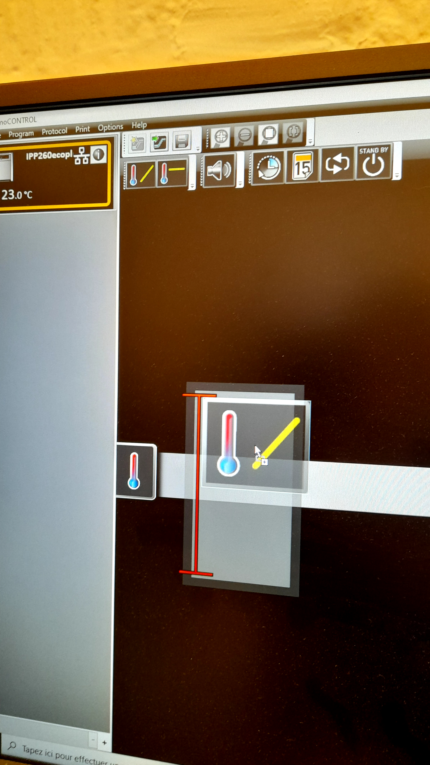
specs/v2-2025/sensors/differential pressure sensor/calibration/pictures/drag.png
