flipoyo/MOLONARI-hardware/specs/v2-2025/sensors/differential pressure sensor/calibration/pictures/top_left.png

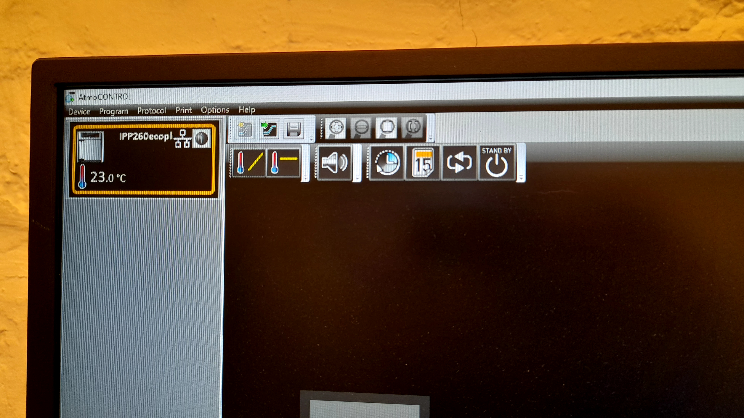
specs/v2-2025/sensors/differential pressure sensor/calibration/pictures/top_left.png
